Juno31/imu-daq/architecture.html

# IMU DAQ architecture

Firmware on the XIAO, a Python server on the PC, and a browser GUI. The board's frame timer is the master clock.

## XIAO ESP32S3 firmware/imu_daq/imu_daq.ino

BNO085 A4B0x4B

BNO085 A4A0x4A

→ I2C →

loop()reads IMUs, restarts silent ones

→

latest[]newest quaternions

esp_timerevery 10 ms (5 ms at 200 Hz)

→

onTick()snapshot latest[]

→

ring[512]frame queue

→

USB linesF (recording) / P (idle)

onTick()while recording

→

SYNC pin D1 high1 ms; 3 ms for frame 0

↓SYNC wireone pulse per frame (D1 → ai0)

↓USB serial (COM4)frames, @messages, ping/pong

## NI USB-6363

ai0 = SYNCedge timed to 1 sample

ai16 – ai23 = EMG01 – EMG08same sample clock (map below)

→ USB to the PC, read by daq.py

## PC: server.py conda env "daq"

daq.pyDAQ reader thread → daq_raw.f32, edge detection

device.pyserial reader thread → frames, @messages, pongs

clocksync.pyping/pong → board↔PC clock fit

syncmon.pylive pulse↔frame matching

session.pywrites the session folder

Appstate machine + HTTP server (port 8765)

↓HTTP + live stream (SSE)frames every 40 ms, status every 250 ms

## Browser GUI index.html + app.js + app.css

ButtonsStart / Stop / Marker / settings

IMU cards3D view, angles, plots

Sync monitorscope, match strip, clock plots

Log + sessionsevents, recent recordings

## DAQ channel map (Differential: AI n+ with AI n+8 −)

Signal | Muscle | Side | Channel | + pin | − pin
SYNC | XIAO D1 | — | ai0 | AI 0 | AI 8
EMG01 | Lumbar erector spinae | L | ai16 | AI 16 | AI 24
EMG02 | Lumbar erector spinae | R | ai17 | AI 17 | AI 25
EMG03 | Lumbar multifidus | L | ai18 | AI 18 | AI 26
EMG04 | Lumbar multifidus | R | ai19 | AI 19 | AI 27
EMG05 | External oblique | L | ai20 | AI 20 | AI 28
EMG06 | External oblique | R | ai21 | AI 21 | AI 29
EMG07 | Internal oblique | L | ai22 | AI 22 | AI 30
EMG08 | Internal oblique | R | ai23 | AI 23 | AI 31

GUI → Time sync → Extra channels: ai16,ai17,ai18,ai19,ai20,ai21,ai22,ai23. EMG system ground also to a DAQ AI GND pin. The range (±5 / ±10 V) applies to all channels.

## How the three clocks are linked

Link | How | Accuracy
Board → DAQ | SYNC pulse per frame, in hardware | ≈ 14 µs at 20 kHz
Board → PC | USB ping/pong, line fit | ≈ ±0.4 ms
DAQ → EMG / other inputs | same sample clock | exact

SID Lab spine study (frozen design): 7 BNO086 pods C7–S1 on two TCA9548A muxes and a Teensy 4.1 logger, 4 paraspinal EMG + 1 ECG on MyoWare 2, an NI USB-6003, two 10 m Cat6 tethers, and a laptop on battery. The Teensy frame timer is the master clock; its SYNC edge is recorded on AI4.

Solid blue: I2C (Qwiic) · grey: USB · dashed / thick red: SYNC + Cable B · orange: EMG / ECG analog + Cable A. Pods 1–4 (C7–T9) on Mux A ports 0–3 and pods 5–7 (T12–S1) on Mux B ports 0–2, confirmed by the lab.

## Tether pinout (RJ45 → spring terminal)

Cable | RJ45 pins | Signal | DAQ input
A | 1 / 2 | EMG1 L longissimus (signal / own GND) | AI0 / AI GND
A | 3 / 6 | EMG2 R longissimus | AI1 / AI GND
A | 4 / 5 | EMG3 L multifidus | AI2 / AI GND
A | 7 / 8 | EMG4 R multifidus | AI3 / AI GND
B | 1 | SYNC (Teensy pin 2) | AI4
B | 3 | ECG | AI5
B | 2 / 6 / 8 | GND (8 = bias) | AI GND
— (at the DAQ) | jumper | MARK: GUI pulses digital out P0.0 | AI6

Event marker: the GUI Mark key pulses USB-6003 digital output P0.0; a short jumper on the DAQ terminal block feeds it to AI6, so each marker is sampled on the same 2 kHz clock as EMG and SYNC (±0.5 ms). This replaces the hub Qwiic Button (frozen in the brief; confirm with the senior before removing its cutout in brace_v4.scad).

Safety: the laptop runs on battery while recording (no mains loop). Never plug a powered Link Shield lead into a Cable Shield jack; never switch MyoWare modes while powered.

## Parts status (purchase list)

Block | Part | Qty | Use | Status
IMU | SparkFun BNO086 Qwiic SEN-22857 | 8 | 7 pods + 1 spare | arrived
IMU | Qwiic Button BOB-15932 | 2 | spares (GUI marker on AI6 replaces the MARK button) | arrived
IMU | Qwiic Mux TCA9548A BOB-16784 | 2 | Mux A, Mux B | expected 26.11.16
IMU | Qwiic cables 50 cm / 20 cm, cable kit | 10 / 10 / 2 | pod chain, hub | cables 26.11.16, kit arrived
Logger | Teensy 4.1 DEV-16996 | 1 | logger, SYNC | expected 26.11.16
EMG | MyoWare 2 DEV-27924 + Cable Shield + Link Shield | 8 each | 4 EMG + 1 ECG + 3 spare | shields arrived, sensors 26.11.16
EMG | CAB-12970 electrode cable 61 cm | 8 | electrodes | arrived
EMG | 3.5 mm TRS cable 30–50 cm, TRRS breakout 5764 | 10 / 8 | Link Shield leads → terminals | cables 26.11.16, breakouts arrived
Hub | Wago 221-415 | 5 | 3V3 / GND buses | expected 26.11.16
Tether | Cat6 FTP 10 m + RJ45 spring adapters | 2 / 4 | Cable A, Cable B, both ends | arrived
Hub | microSD 32 GB, power bank (always-on), jumpers, resistors | — | logging, power, gain-check divider | arrived

Not in the list: the NI USB-6003 (assumed already in the lab). With 6 of 8 AI inputs used, 8 EMG channels would not fit on this DAQ.
