Juno31/imu-daq/assets/imu_daq.png

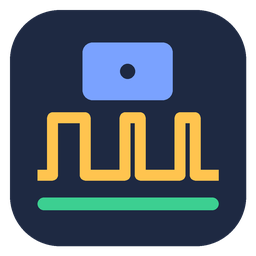
assets/imu_daq.png
