Juno31/imu-daq/hardware/dimension/myoware2/board_dimensions.png

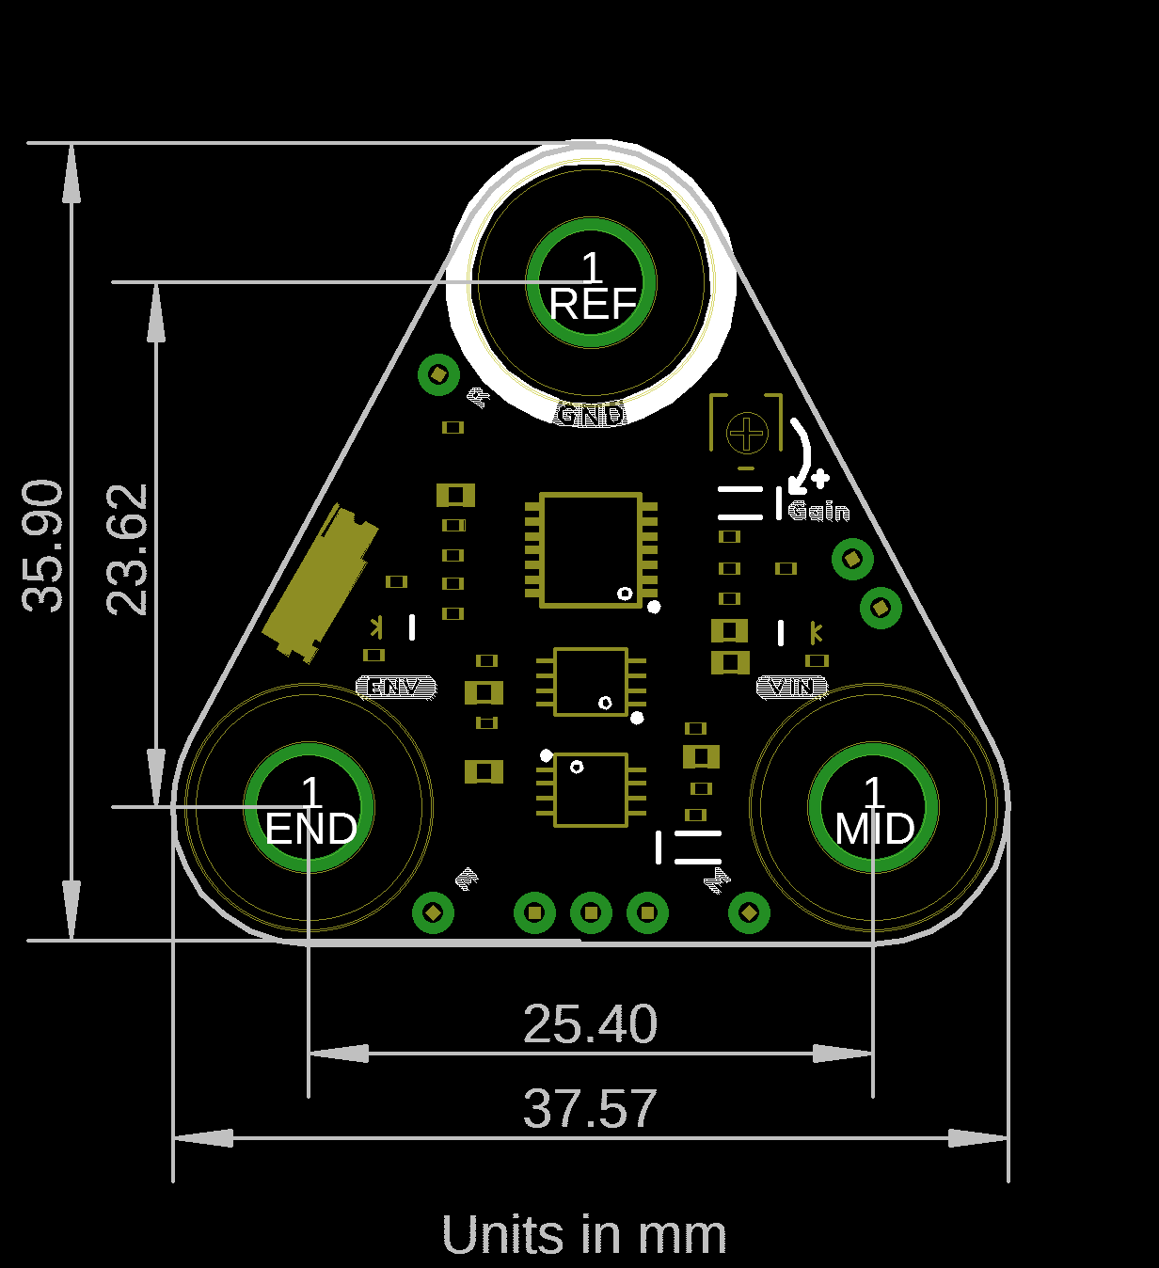
hardware/dimension/myoware2/board_dimensions.png
