Juno31/imu-daq/hardware/jig/preview_bottom.png

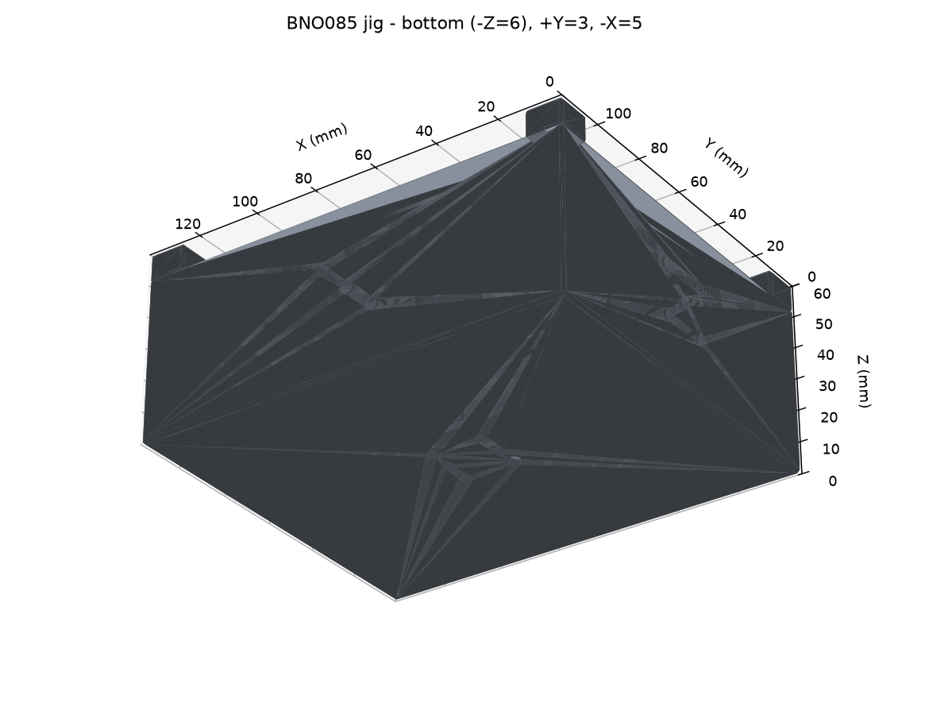
hardware/jig/preview_bottom.png
