Juno31/imu-daq/hardware/jig/preview_coupon.png

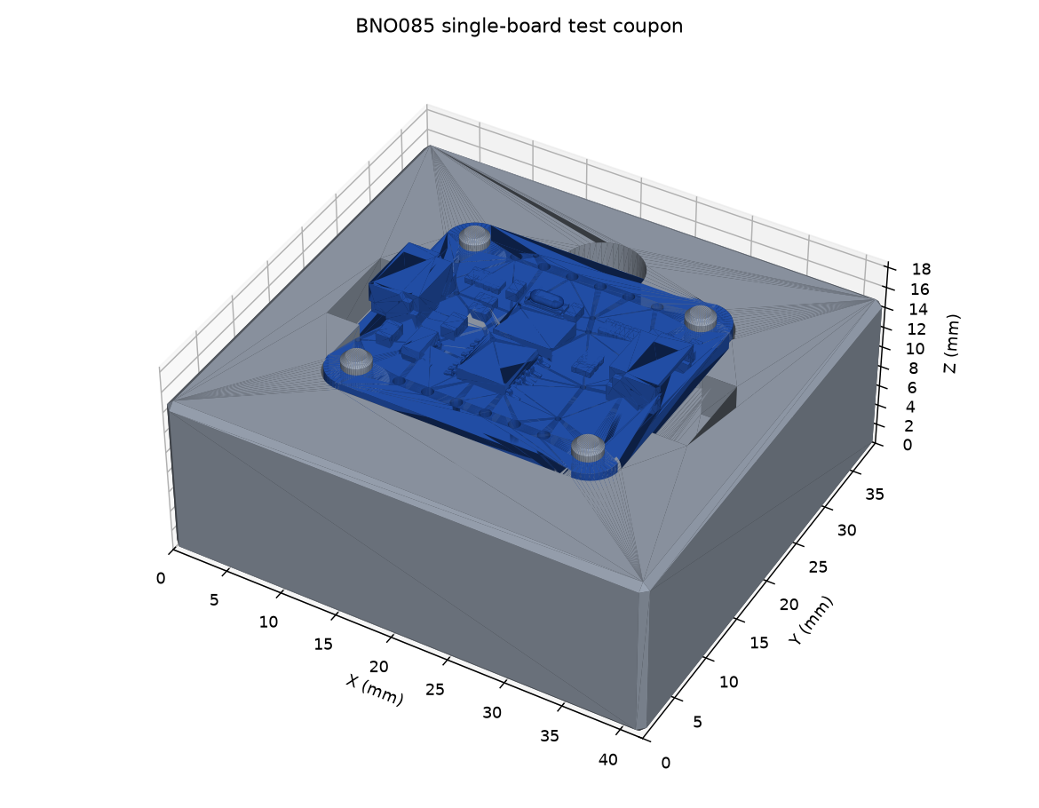
hardware/jig/preview_coupon.png
