Juno31/imu-daq/hardware/jig/preview_coupon_BNO086.png

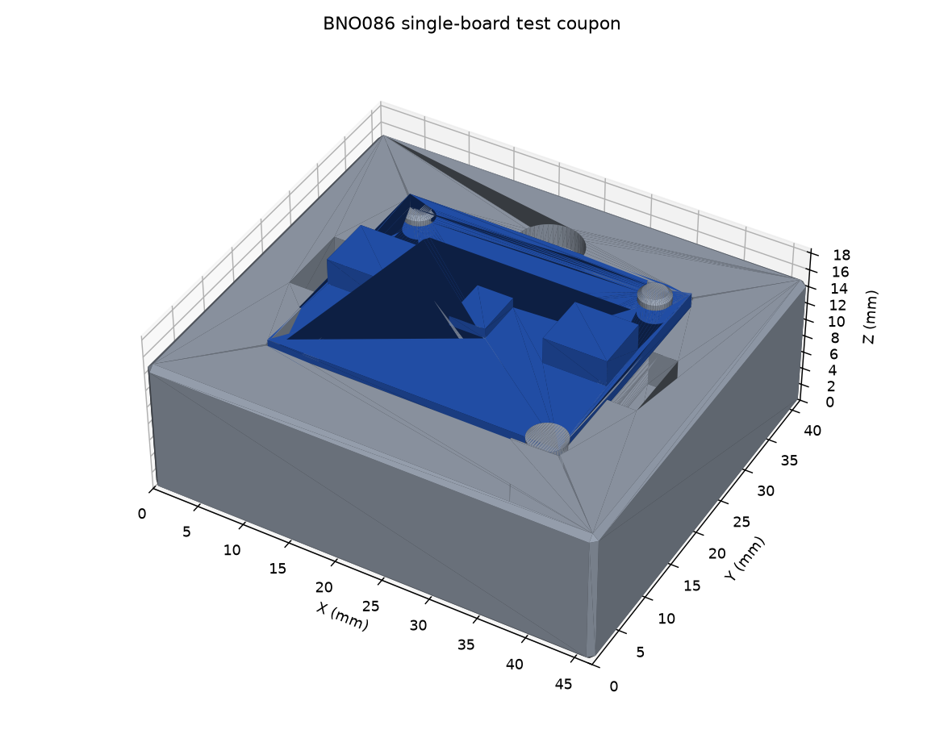
hardware/jig/preview_coupon_BNO086.png
