Juno31/imu-daq/hardware/jig/preview_coupon_empty.png

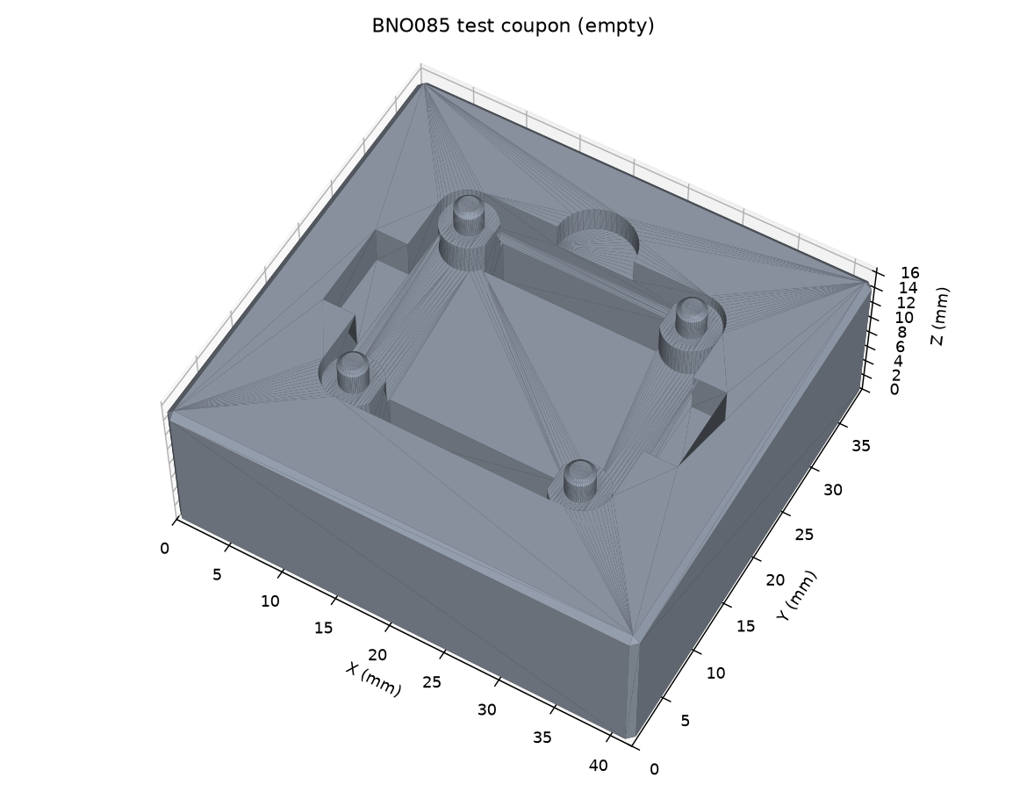
hardware/jig/preview_coupon_empty.png
