Juno31/imu-daq/hardware/jig/preview_coupon_snap.png

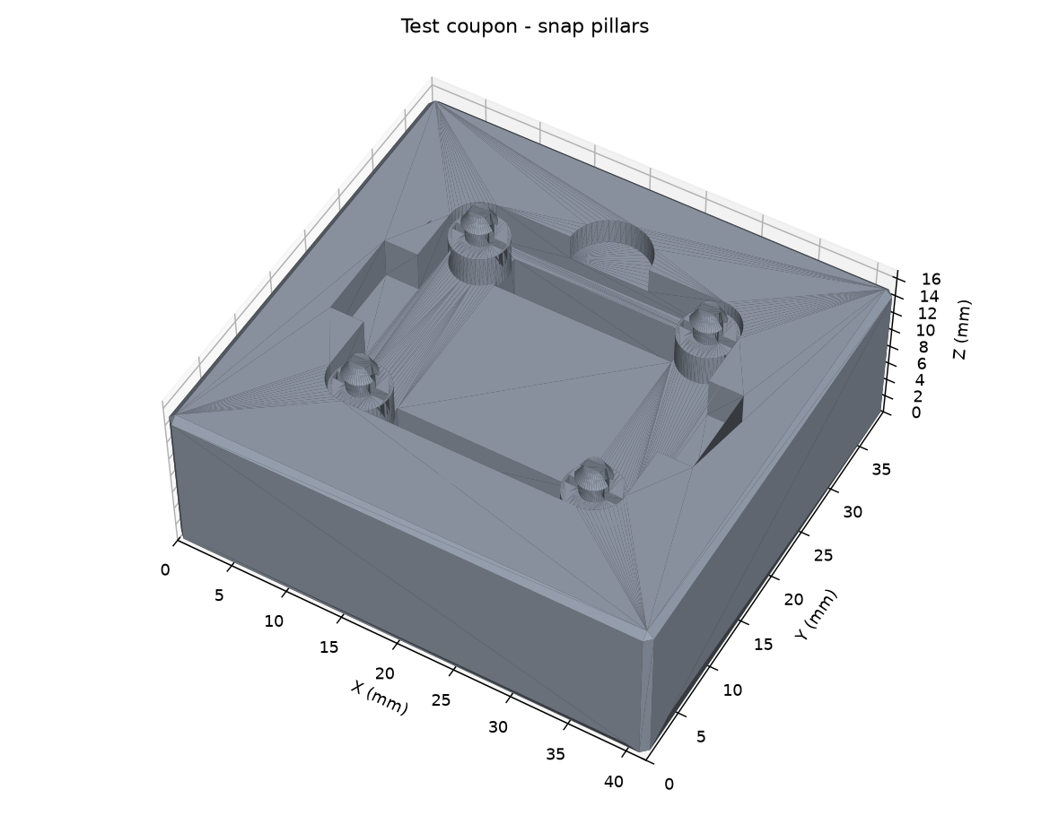
hardware/jig/preview_coupon_snap.png
