Juno31/imu-daq/hardware/jig/preview_iso.png

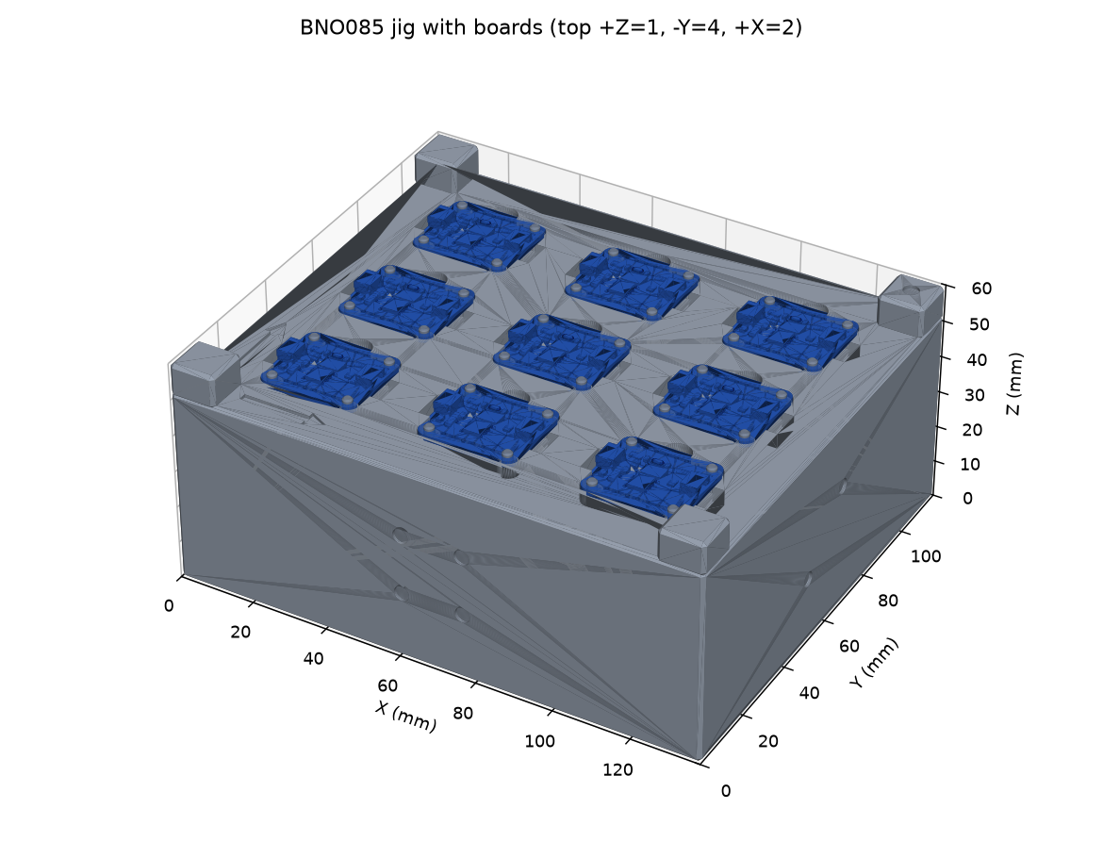
hardware/jig/preview_iso.png
