Juno31/imu-daq/hardware/jig/preview_pin_closeup.png

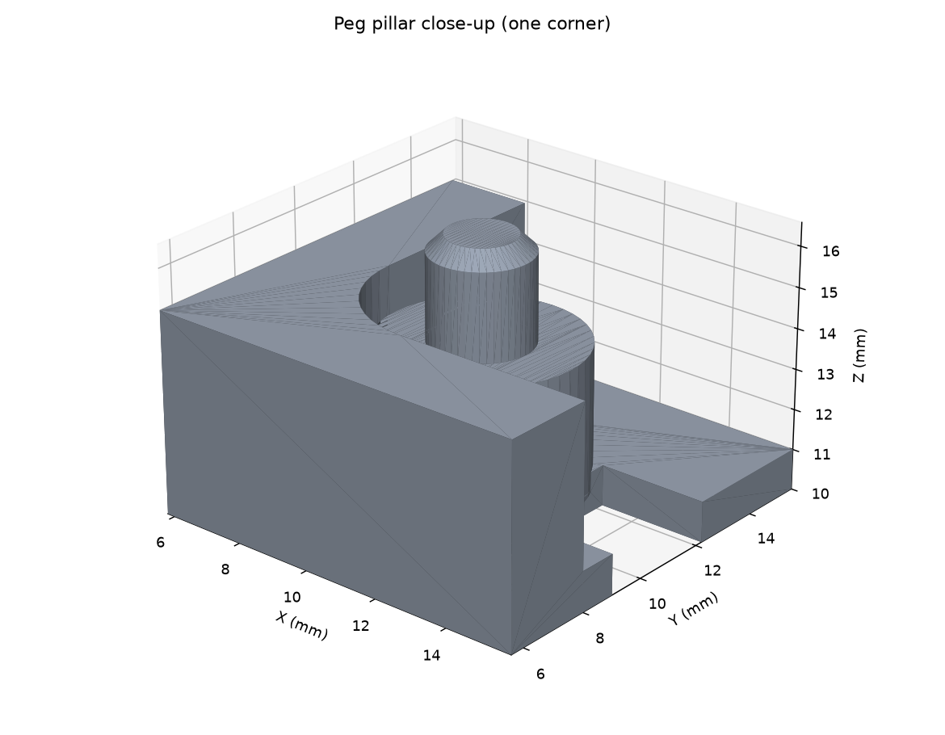
hardware/jig/preview_pin_closeup.png
