Juno31/imu-daq/hardware/dimension/dimensions.csv

board | feature | value_mm | basis | source
XIAO ESP32S3 | nominal_length | 21 | manufacturer specification | https://wiki.seeedstudio.com/xiao_esp32s3_getting_started/
XIAO ESP32S3 | nominal_width | 17.8 | manufacturer specification | https://wiki.seeedstudio.com/xiao_esp32s3_getting_started/
XIAO ESP32C3 | nominal_length | 21 | manufacturer specification | https://wiki.seeedstudio.com/XIAO_ESP32C3_Getting_Started/
XIAO ESP32C3 | nominal_width | 17.8 | manufacturer specification | https://wiki.seeedstudio.com/XIAO_ESP32C3_Getting_Started/
Adafruit BNO085 | CAD_outline_X | 25.4 | Eagle layer 20 | adafruit_bno085/Adafruit_BNO08x.brd
Adafruit BNO085 | CAD_outline_Y | 22.86 | Eagle layer 20 | adafruit_bno085/Adafruit_BNO08x.brd
Adafruit BNO085 | corner_radius | 2.54 | derived from Eagle arc endpoints and 90 degree sweep | adafruit_bno085/Adafruit_BNO08x.brd
Adafruit BNO085 | mount_hole_drill | 2.5 | CAD plated pad drill; not guaranteed finished diameter | adafruit_bno085/Adafruit_BNO08x.brd
Adafruit BNO085 | mount_spacing_X | 20.32 | CAD coordinate subtraction | adafruit_bno085/Adafruit_BNO08x.brd
Adafruit BNO085 | mount_spacing_Y | 17.78 | CAD coordinate subtraction | adafruit_bno085/Adafruit_BNO08x.brd
Adafruit BNO085 | product_length | 25.6 | product listing differs from CAD | https://www.adafruit.com/product/4754
Adafruit BNO085 | product_width | 22.7 | product listing differs from CAD | https://www.adafruit.com/product/4754
Adafruit BNO085 | product_height | 4.6 | product listing; not PCB thickness | https://www.adafruit.com/product/4754
SparkFun BNO086 | CAD_outline_X | 30.48 | Eagle layer 20 | https://docs.sparkfun.com/SparkFun_VR_IMU_Breakout_BNO086_QWIIC/single_page/
SparkFun BNO086 | CAD_outline_Y | 25.4 | Eagle layer 20 | https://docs.sparkfun.com/SparkFun_VR_IMU_Breakout_BNO086_QWIIC/single_page/
SparkFun BNO086 | mount_hole_diameter | 3.302 | Eagle STAND-OFF hole | https://docs.sparkfun.com/SparkFun_VR_IMU_Breakout_BNO086_QWIIC/single_page/
SparkFun BNO086 | mount_spacing | 25.4 | CAD coordinate subtraction | https://docs.sparkfun.com/SparkFun_VR_IMU_Breakout_BNO086_QWIIC/single_page/
SparkFun BNO086 | assembled_height |  | not verified | https://docs.sparkfun.com/SparkFun_VR_IMU_Breakout_BNO086_QWIIC/single_page/
MyoWare 2 DEV-27924 | outline_width | 37.57 | official dimension drawing | https://www.sparkfun.com/myoware-2-muscle-sensor.html
MyoWare 2 DEV-27924 | outline_height_in_plane | 35.9 | official dimension drawing | https://www.sparkfun.com/myoware-2-muscle-sensor.html
MyoWare 2 DEV-27924 | END_MID_center_spacing | 25.4 | official dimension drawing | https://www.sparkfun.com/myoware-2-muscle-sensor.html
MyoWare 2 DEV-27924 | REF_vertical_offset_from_END_MID | 23.62 | official dimension drawing | https://www.sparkfun.com/myoware-2-muscle-sensor.html
MyoWare 2 DEV-27924 | assembled_height |  | not verified | https://www.sparkfun.com/myoware-2-muscle-sensor.html
Teensy 4.1 DEV-16996 | PCB_length | 60.96 | PJRC drawing | https://www.pjrc.com/store/teensy41.html
Teensy 4.1 DEV-16996 | PCB_width | 17.78 | PJRC drawing | https://www.pjrc.com/store/teensy41.html
Teensy 4.1 DEV-16996 | PCB_width_tolerance_plus_minus | 0.6 | PJRC drawing | https://www.pjrc.com/store/teensy41.html
Teensy 4.1 DEV-16996 | PCB_thickness | 1.57 | PJRC drawing | https://www.pjrc.com/store/teensy41.html
Teensy 4.1 DEV-16996 | pin_pitch | 2.54 | PJRC drawing | https://www.pjrc.com/store/teensy41.html
Teensy 4.1 DEV-16996 | outer_pin_row_spacing | 15.24 | PJRC drawing | https://www.pjrc.com/store/teensy41.html
Teensy 4.1 DEV-16996 | USB_front_overhang | 0.7 | PJRC drawing | https://www.pjrc.com/store/teensy41.html
Teensy 4.1 DEV-16996 | USB_above_PCB | 2.5 | PJRC side drawing | https://www.pjrc.com/store/teensy41.html
Teensy 4.1 DEV-16996 | USB_below_PCB | 0.6 | PJRC side drawing | https://www.pjrc.com/store/teensy41.html
Teensy 4.1 DEV-16996 | finished_hole_59_locations | 0.965 | PJRC product text | https://www.pjrc.com/store/teensy41.html
Teensy 4.1 DEV-16996 | finished_hole_6_locations | 0.762 | PJRC product text | https://www.pjrc.com/store/teensy41.html
Teensy 4.1 DEV-16996 | assembled_height_with_headers |  | not verified; header dimensions unavailable | https://www.pjrc.com/store/teensy41.html
