Juno31/imu-daq/hardware/dimension/adafruit_bno085/4754_BNO085_STEMMA_QT.step

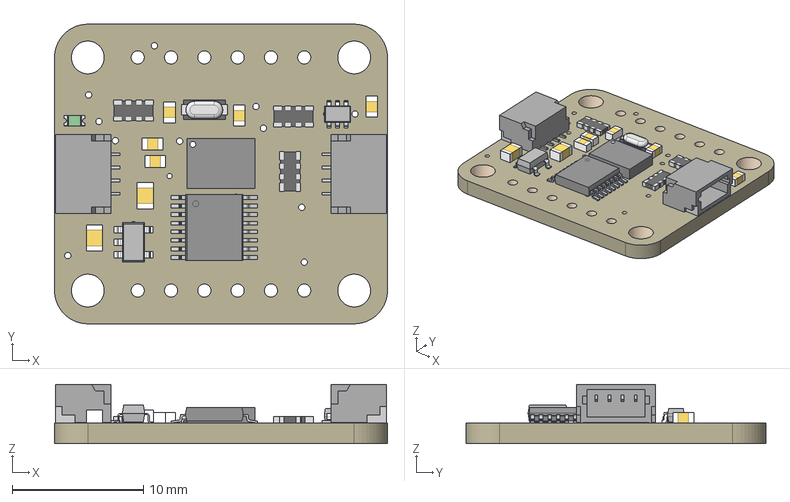
[picture p11: CAD file, 2026-11-13]
hardware/dimension/adafruit_bno085/4754_BNO085_STEMMA_QT.step
25.4 x 22.9 x 4.53 mm
Board
10uF x 2
AP2112K-3.3
22pF x 5
10K x 3
BSS138
STEMMA_I2C_QT x 2
GREEN
BNO080
74AHC4050
