Juno31/imu-daq/hardware/dimension/xiao_esp32c3/bottom_dimensions_v1.2_extracted/XIAO ESP32C3 v1.2 Dimensioning.dxf

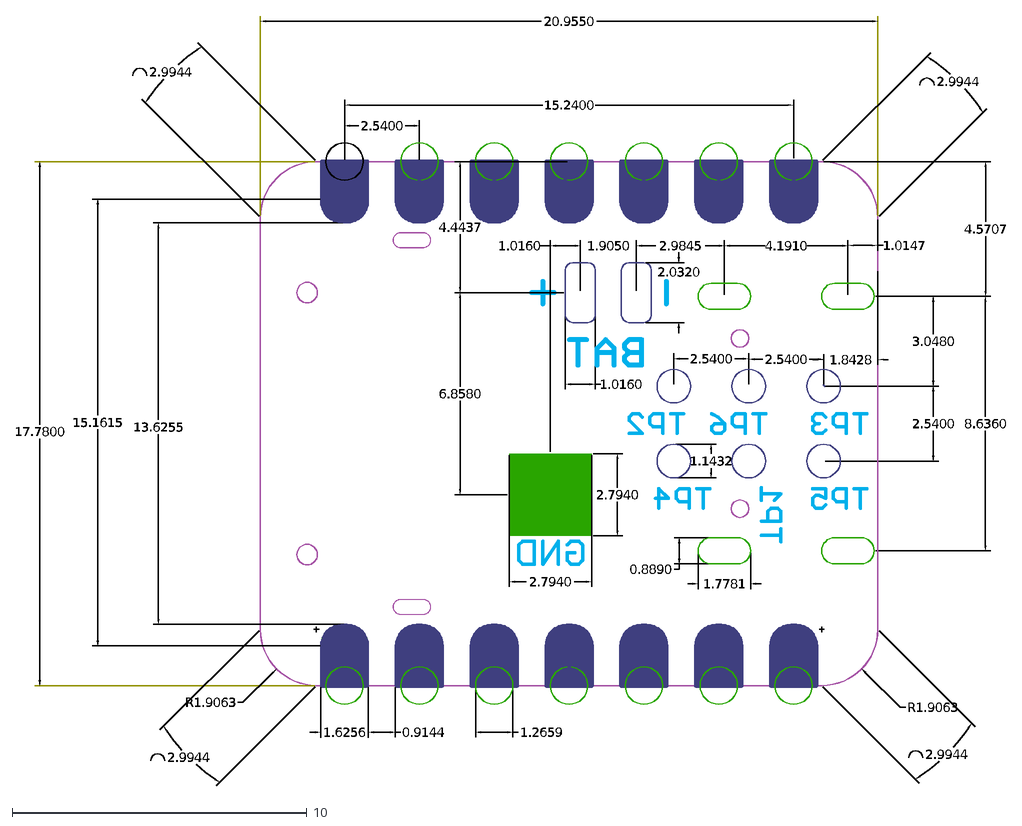
[picture p12: CAD file, 2026-11-13]
hardware/dimension/xiao_esp32c3/bottom_dimensions_v1.2_extracted/XIAO ESP32C3 v1.2 Dimensioning.dxf
1.0160
1.9050
1.7781
0.8890
8.6360
2.5400
4.1910
1.1432
20.9550
17.7800
15.2400
1.6256
R1.9063
2.9944
0.9144
13.6255
15.1615
1.2659
2.9845
1.0147
3.0480
1.8428
4.4437
2.0320
4.5707
2.7940
6.8580
