Juno31/imu-daq/hardware/dimension/xiao_esp32c3/dimensions_extracted/113991054/top.dxf

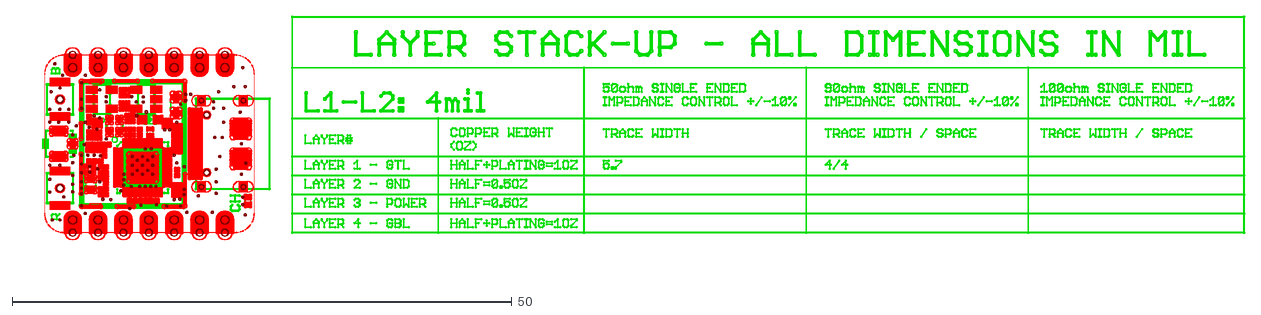
[picture p13: CAD file, 2026-11-13]
hardware/dimension/xiao_esp32c3/dimensions_extracted/113991054/top.dxf
122.9 x 25.9
