Juno31/imu-daq/hardware/dimension/xiao_esp32s3/dimensions_v1.1.dxf

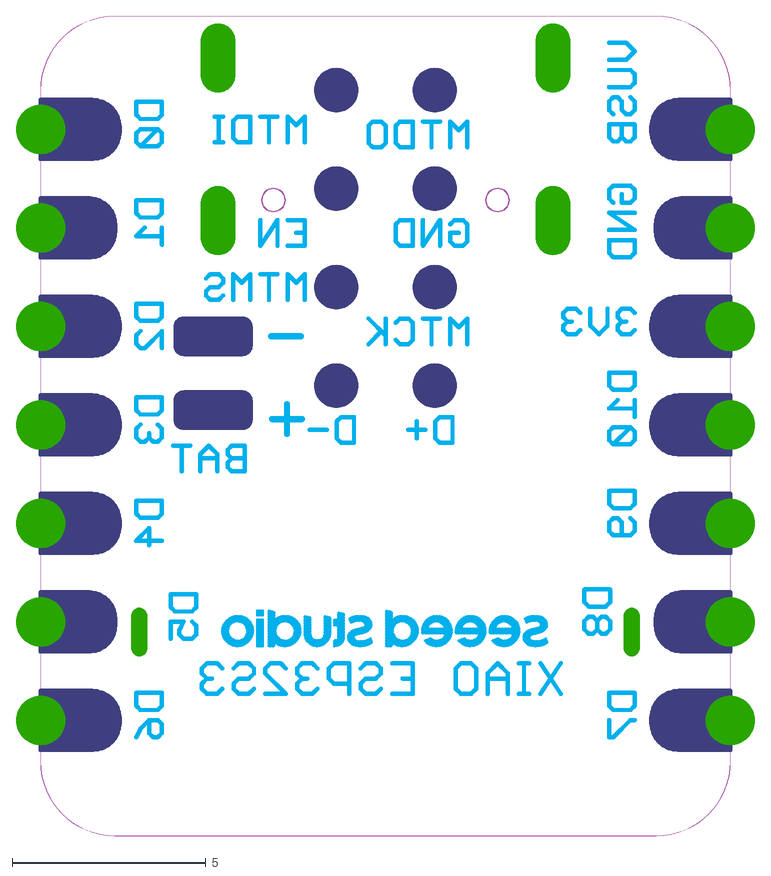
[picture p14: CAD file, 2026-11-13]
hardware/dimension/xiao_esp32s3/dimensions_v1.1.dxf
19.0 x 21.1
