Juno31/imu-daq/hardware/dimension/xiao_esp32c3/dimensions_extracted/113991054/bottom.dxf

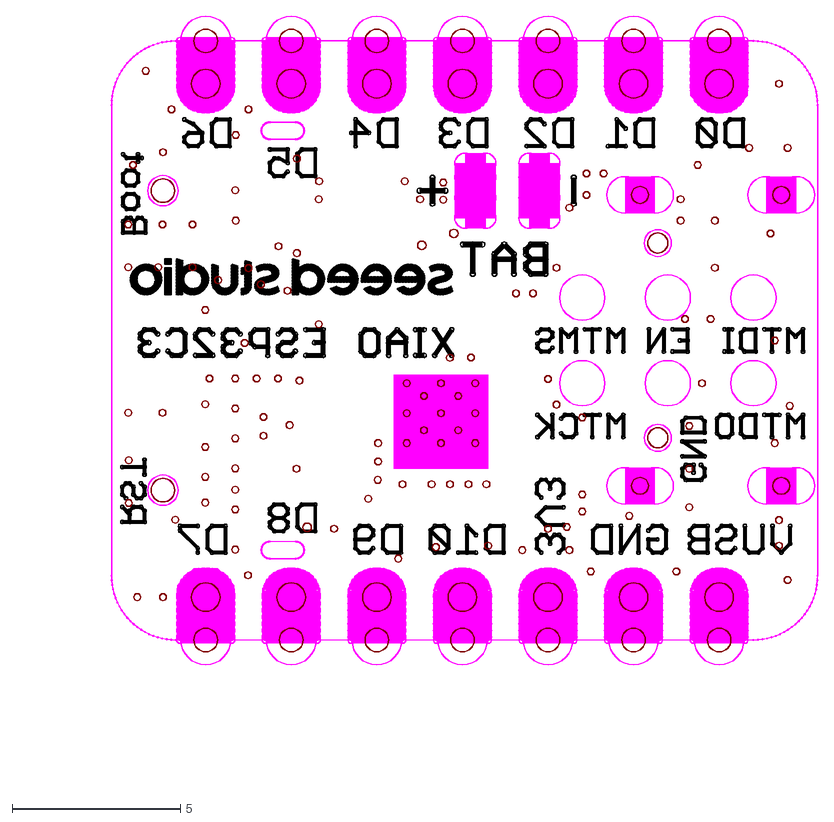
[picture p17: CAD file, 2026-11-13]
hardware/dimension/xiao_esp32c3/dimensions_extracted/113991054/bottom.dxf
23.8 x 22.7
