Juno31/imu-daq/hardware/jig/imu_jig_PLA-CF.stl

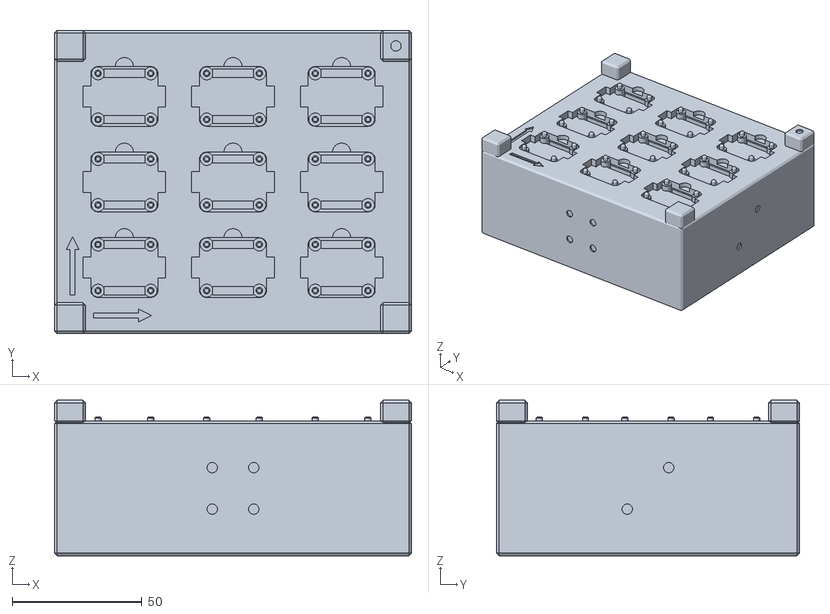
[picture p18: CAD file, 2026-11-13]
hardware/jig/imu_jig_PLA-CF.stl
137.7 x 117.0 x 60.0
