Juno31/imu-daq/hardware/jig/imu_jig_test_coupon_peg_BNO086_PLA-CF.stl

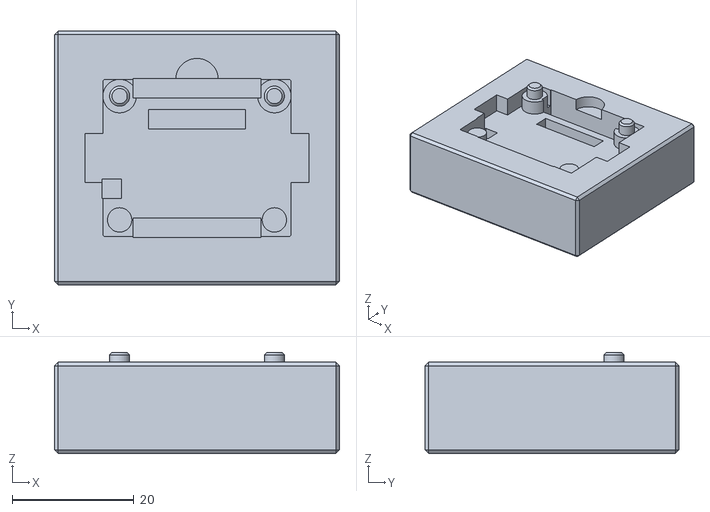
[picture p19: CAD file, 2026-11-13]
hardware/jig/imu_jig_test_coupon_peg_BNO086_PLA-CF.stl
46.8 x 41.7 x 16.6
