Juno31/imu-daq/hardware/jig/imu_jig_test_coupon_peg_PLA-CF.stl

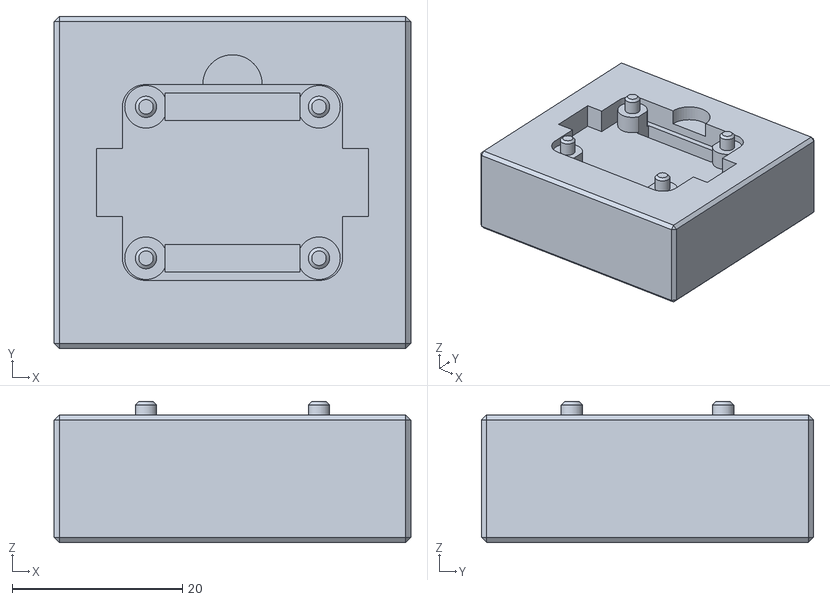
[picture p20: CAD file, 2026-11-13]
hardware/jig/imu_jig_test_coupon_peg_PLA-CF.stl
41.9 x 39.0 x 16.6
