Juno31/imu-daq/hardware/jig/imu_jig_BNO086_PLA-CF.stl

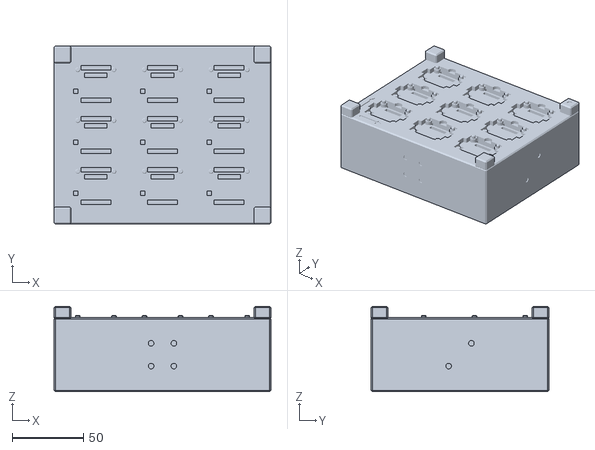
[picture p21: CAD file, 2026-11-13]
hardware/jig/imu_jig_BNO086_PLA-CF.stl
152.3 x 125.1 x 60.0
