Juno31/imu-daq/hardware/jig/imu_jig_test_coupon_screw.stl

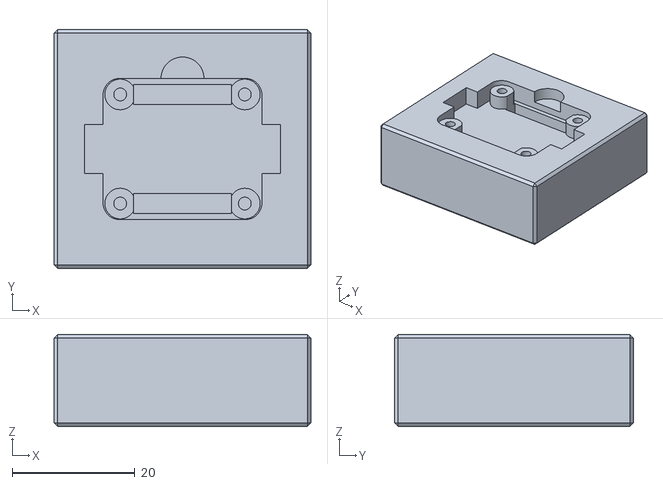
[picture p22: CAD file, 2026-11-13]
hardware/jig/imu_jig_test_coupon_screw.stl
41.9 x 39.0 x 15.0
