Juno31/imu-daq/(list of files, cad)

Other CAD files:
hardware/dimension/adafruit_bno085/4754_BNO085_STEMMA_QT.f3d
hardware/dimension/adafruit_bno085/4754_BNO085_STEMMA_QT.stl
