Juno31/imu-daq/hardware/dimension/adafruit_bno085/manufacturer_README.md

## Adafruit BNO085  9-DOF Orientation IMU Fusion Breakout PCB

<a href="http://www.adafruit.com/products/4754"><br/>
Click here to purchase one from the Adafruit shop</a>

PCB files for the Adafruit BNO085  9-DOF Orientation IMU Fusion Breakout. 

Format is EagleCAD schematic and board layout
* https://www.adafruit.com/product/4754

### Description

### License

Adafruit invests time and resources providing this open source design, please support Adafruit and open-source hardware by purchasing products from [Adafruit](https://www.adafruit.com)!

Designed by Limor Fried/Ladyada for Adafruit Industries.

Creative Commons Attribution/Share-Alike, all text above must be included in any redistribution. 
See license.txt for additional details.
