Juno31/imu-daq/hardware/jig/validation/fit_detail.png

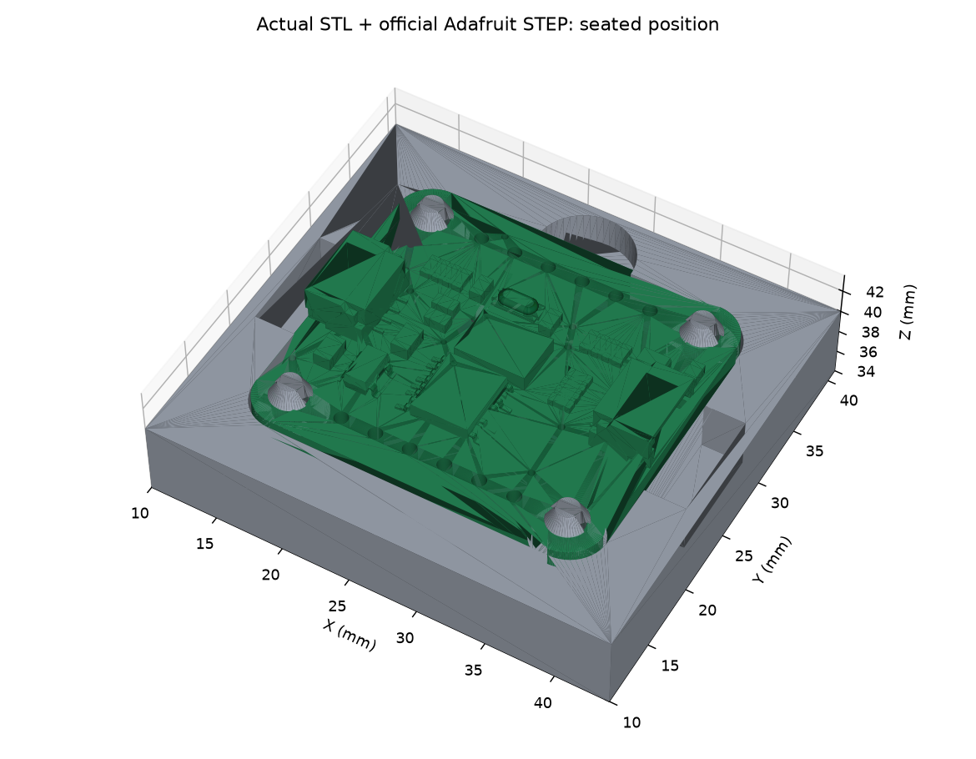
hardware/jig/validation/fit_detail.png
