Juno31/imu-daq/hardware/jig/validation/pin_section.png

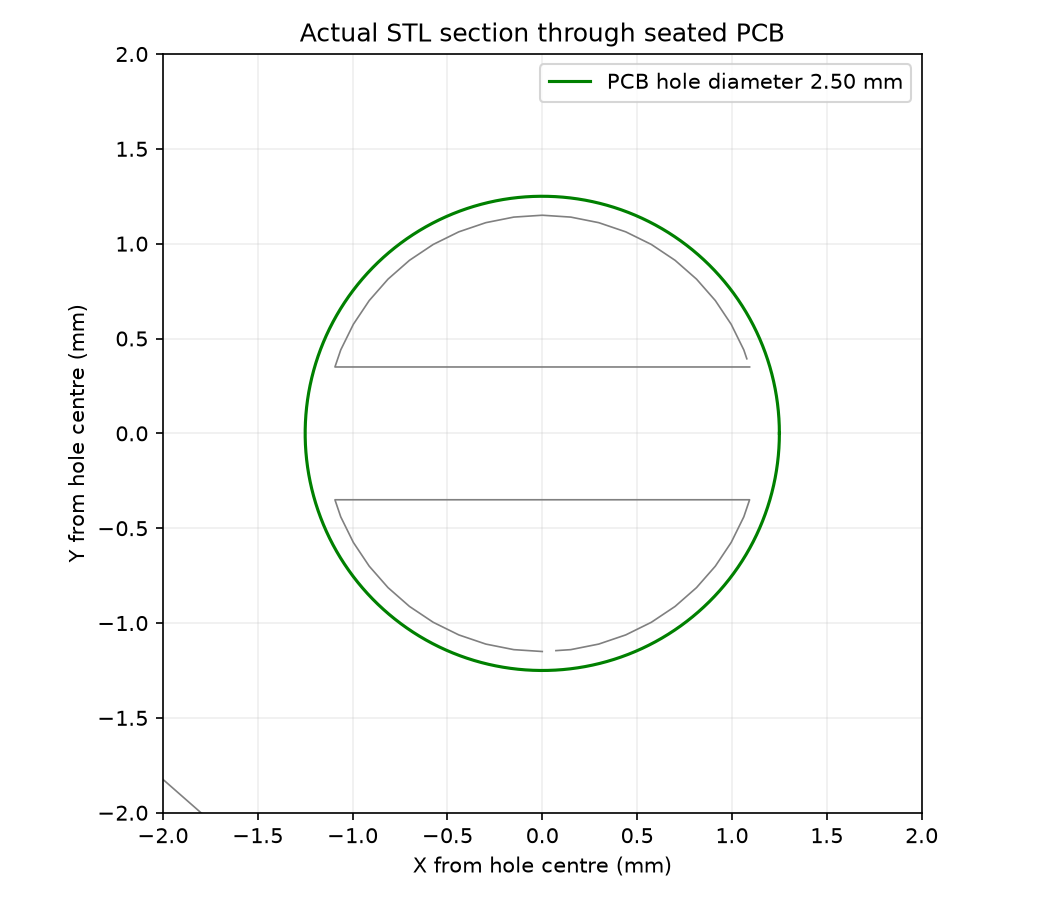
hardware/jig/validation/pin_section.png
