Juno31/imu-daq/(list of files, drawings)

Other design files:
hardware/dimension/adafruit_bno085/pcb_geometry.json
hardware/dimension/sparkfun_bno086/pcb_geometry.json
