Juno31/imu-daq/hardware/dimension/xiao_esp32s3/reference_mismatch/KiCad_extracted/202003753_XIAO ESP32S3 Sense_v1.5_SCH&PCB_260226/XIAO ESP32S3_V1.5.kicad_pcb

## KiCad design hardware/dimension/xiao_esp32s3/reference_mismatch/KiCad_extracted/202003753_XIAO ESP32S3 Sense_v1.5_SCH&PCB_260226/XIAO ESP32S3_V1.5.kicad_pcb (2026-11-13)

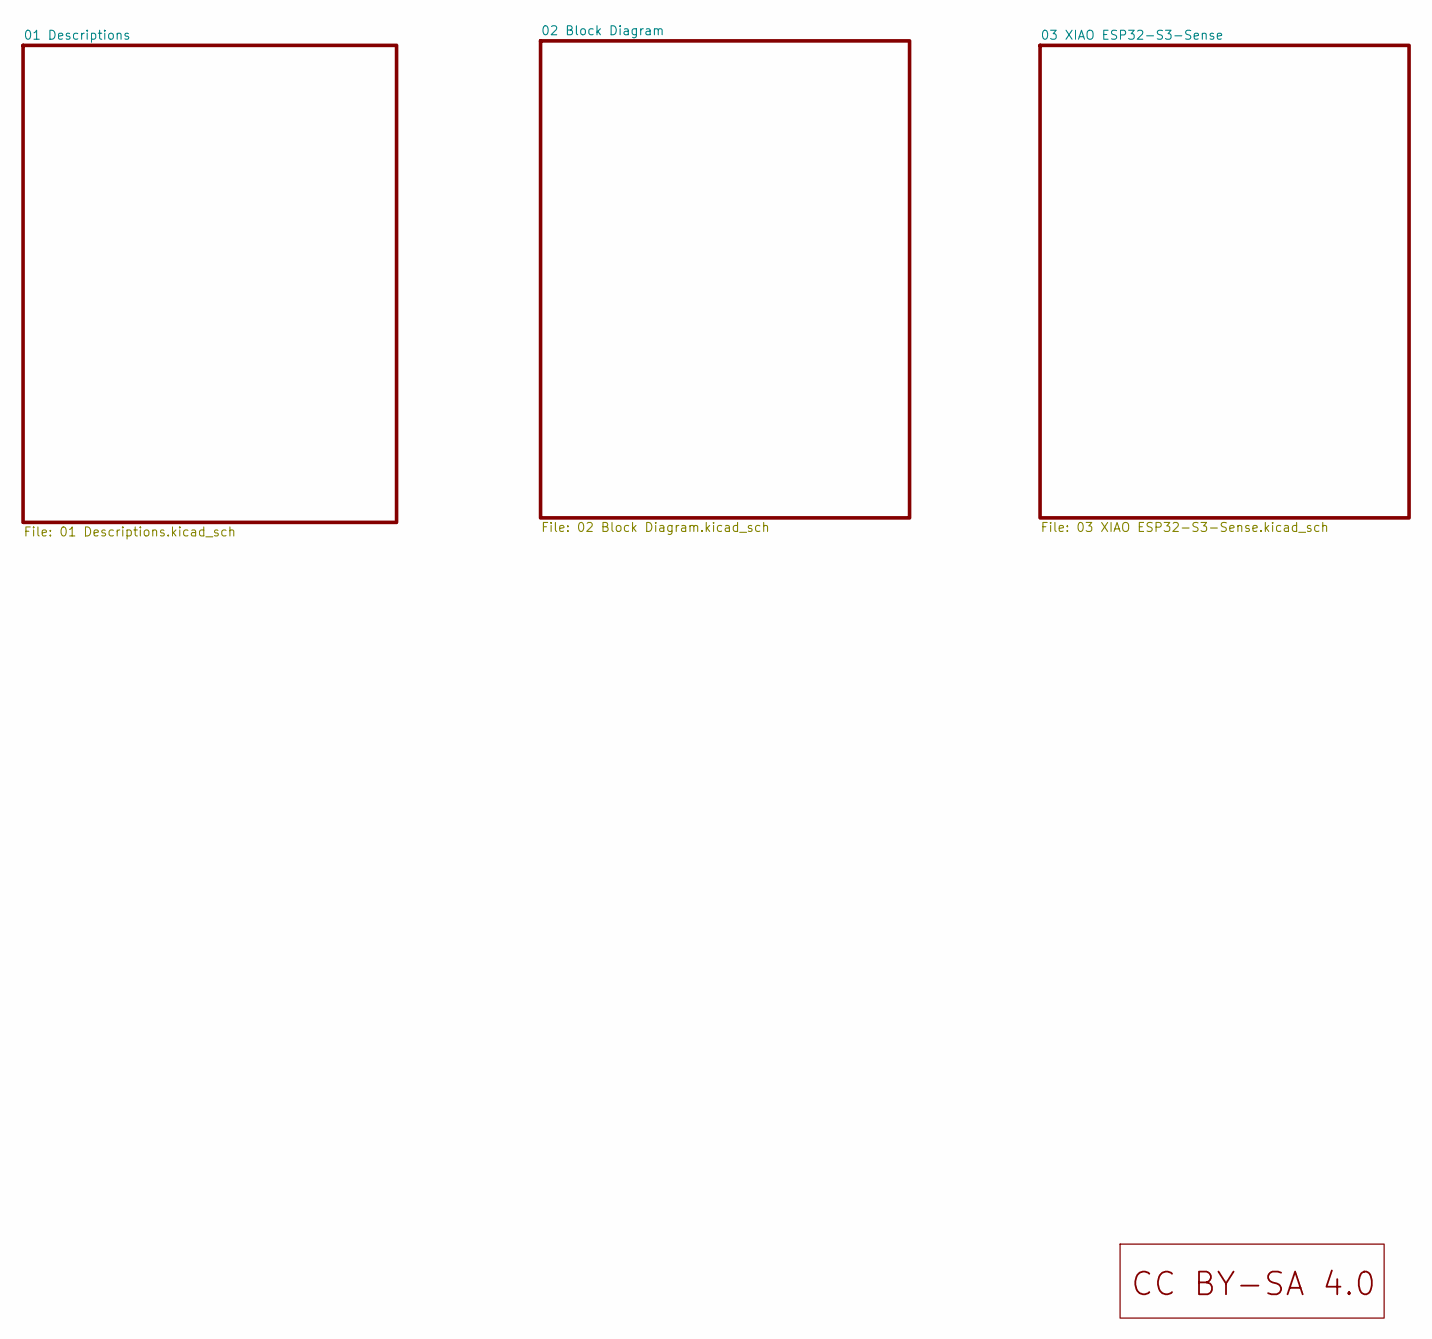
[picture p25: schematic XIAO ESP32S3_V1.5.kicad_sch, XIAO ESP32-S3-Sense]

Parts:
U6: LOGO_CC_BY-SA_4.0

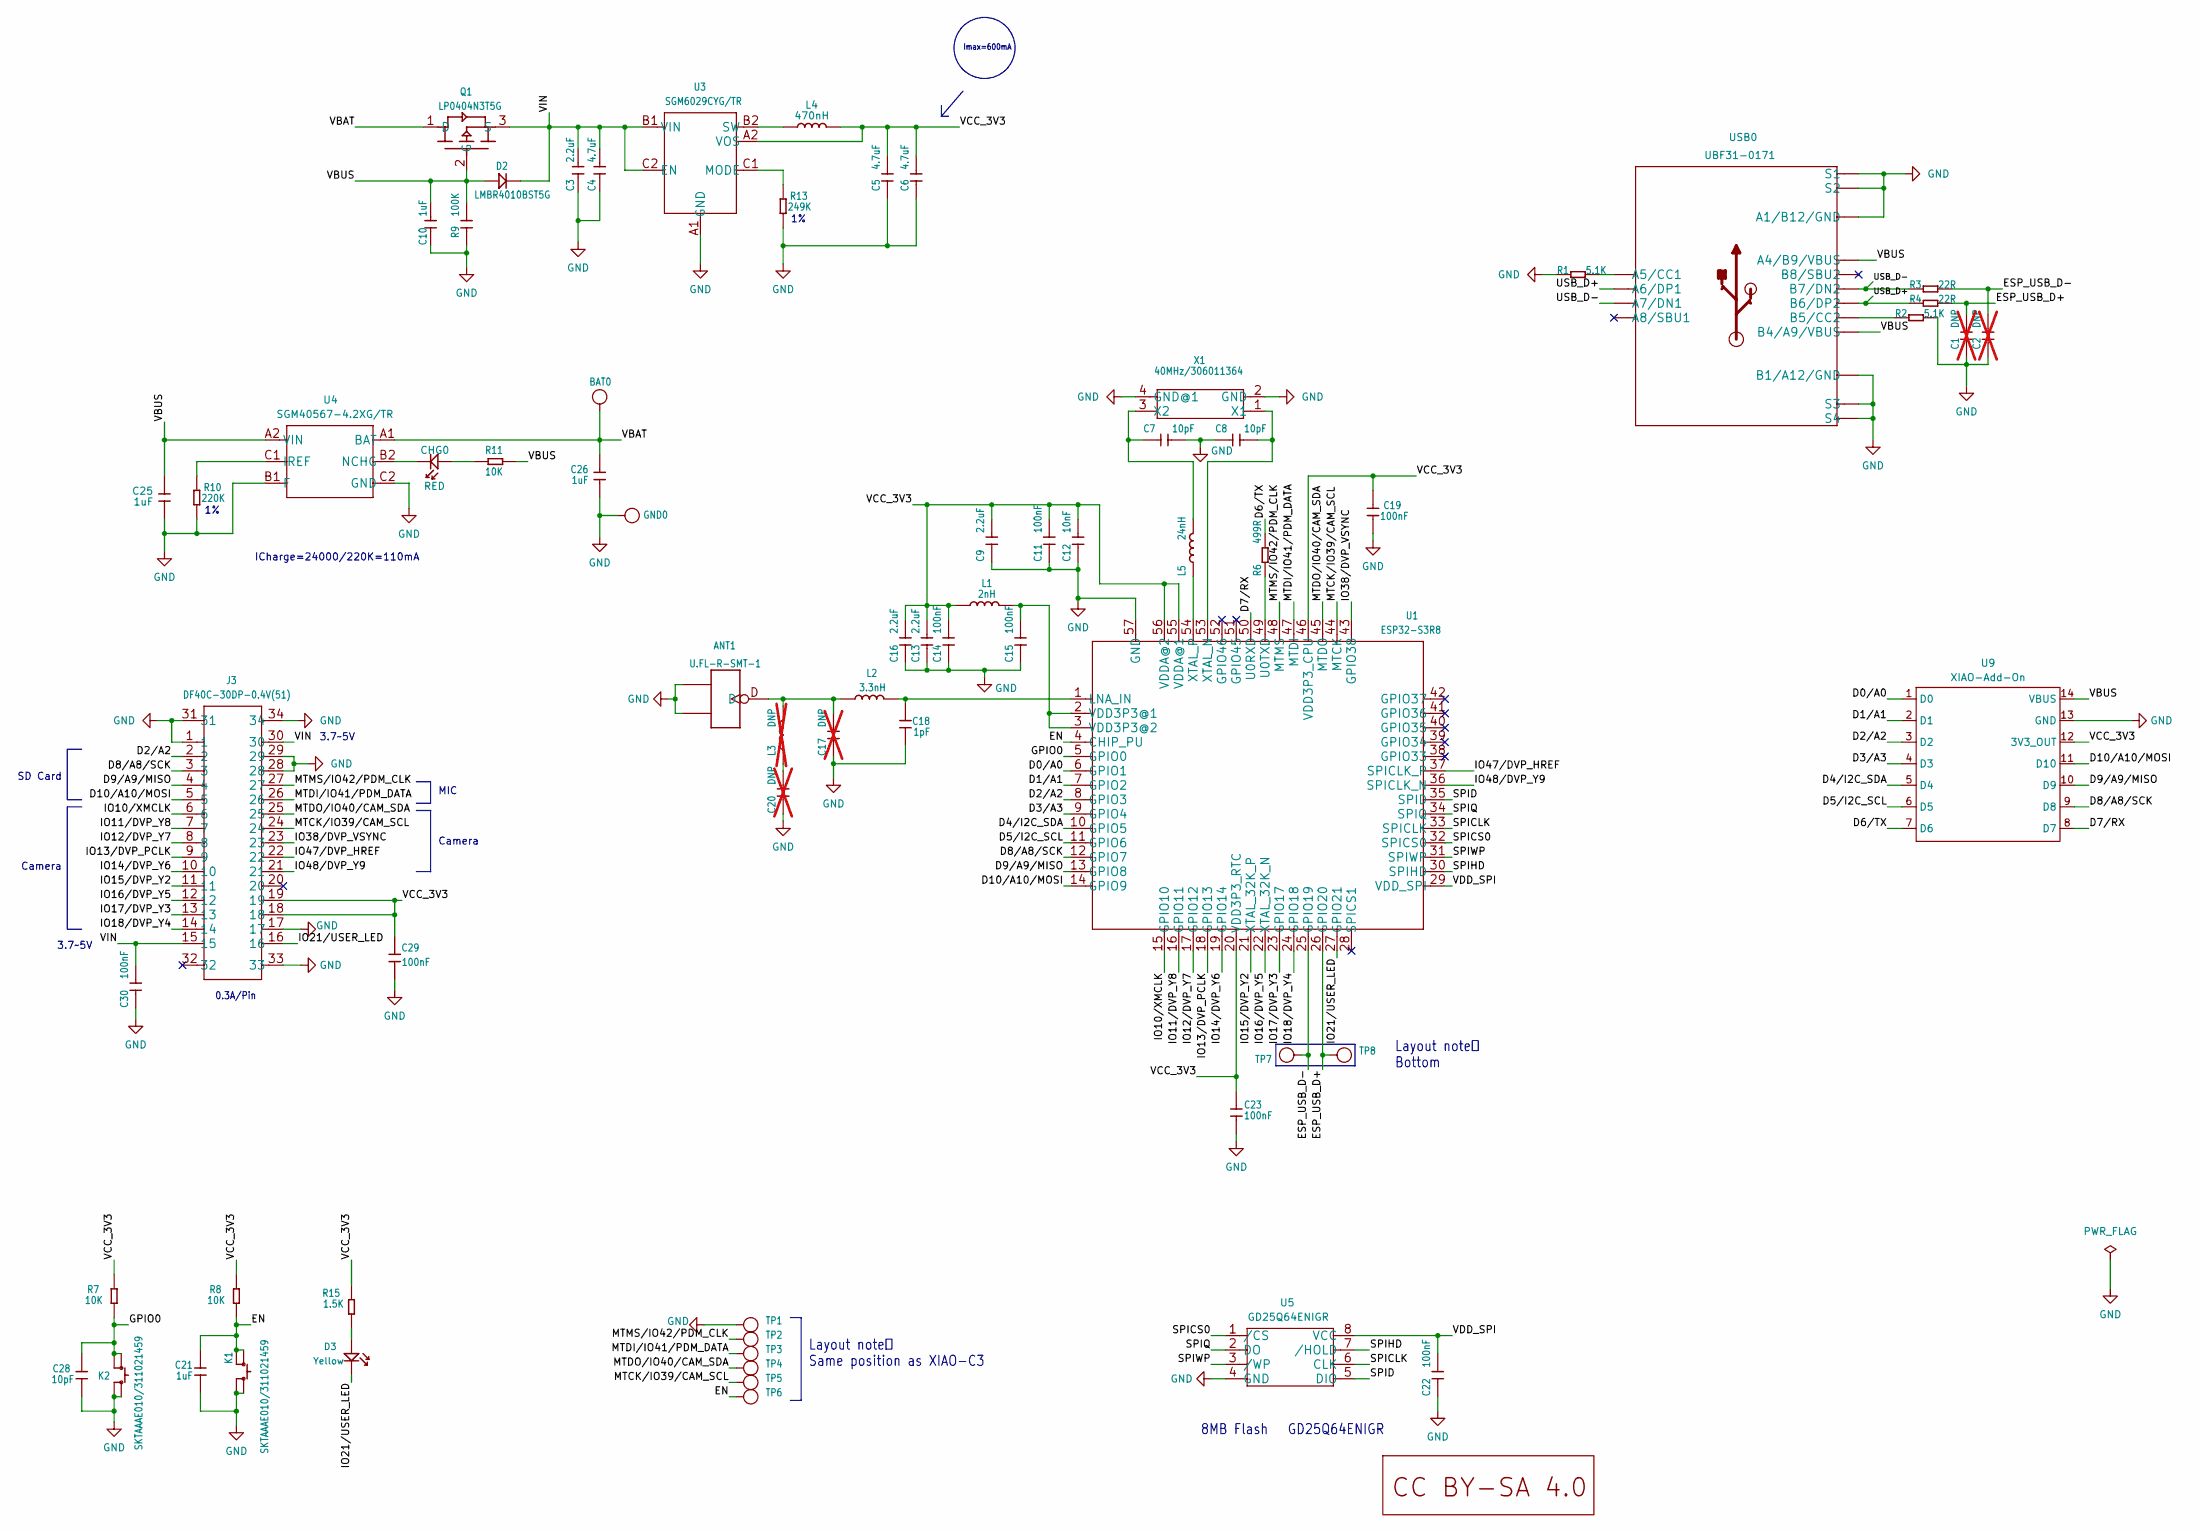
[picture p26: schematic 03 XIAO ESP32-S3-Sense.kicad_sch, XIAO ESP32-S3-Sense]

Parts:
ANT1: U.FL-R-SMT-1; U-FL3P-SMD-2.6X2.6X1.0MM
BAT0: VBAT; TP-80X40MIL
C1, C2, C17, C20: DNP; C0201; not fitted
C3, C9, C13, C16: 2.2uF; C0201
C4, C5, C6: 4.7uF; C0201
C7, C8, C28: 10pF; C0201
C10, C21, C25, C26: 1uF; C0201
C11, C14, C15, C19, C22, C23, C29, C30: 100nF; C0201
C12: 10nF; C0201
C18: 1pF; C0201
CHG0: RED; LED-0402
D2: LMBR4010BST5G; DFN1006-2L
D3: Yellow; LED-0402
GND0: GND; TP-80X40MIL
J3: DF40C-30DP-0.4V(51); BTB30-0.4-7.52X2.97X1.14
K1, K2: SKTAAAE010/311021459; SW4-SMD-2.8-2.6X1.6X0.53MM
L1: 2nH; L0201
L2: 3.3nH; L0201
L3: DNP; L0201; not fitted
L4: 470nH; L0603
L5: 24nH; L0201
Q1: LP0404N3T5G; PMOS_1.0_0.6_0.35MM
R1, R2: 5.1K; R0201
R3, R4: 22R; R0201
R6: 499R; R0201
R7, R8, R11: 10K; R0201
R9: 100K; C0201
R10: 220K; R0201
R13: 249K; R0201
R15: 1.5K; R0201
TP1, TP2, TP3, TP4, TP5, TP6, TP7, TP8: TEST-POINT'4545'; TP-D45MIL
U1: ESP32-S3R8; QFN56G-0.4-7X7MM
U3: SGM6029CYG/TR; BGA6-0.35-0.745X10.95X0.4MM
U4: SGM40567-4.2XG/TR; WLCSP-0.4-0.92X1.16X0.4MM
U5: GD25Q64ENIGR; USON8-0.8-4X3MM
U8: LOGO_CC_BY-SA_4.0
U9: XIAO-Add-On; XIAO-14P-Add-On
USB0: UBF31-0171; USB2.0-TYPE-C
X1: 40MHz/306011364; X4-SMD-1.6X1.2X0.35MM

Connections:
/03 XIAO ESP32-S3-Sense/D0/A0: U1.6 (GPIO1), U9.1 (D0)
/03 XIAO ESP32-S3-Sense/D1/A1: U1.7 (GPIO2), U9.2 (D1)
/03 XIAO ESP32-S3-Sense/D2/A2: J3.2, U1.8 (GPIO3), U9.3 (D2)
/03 XIAO ESP32-S3-Sense/D3/A3: U1.9 (GPIO4), U9.4 (D3)
/03 XIAO ESP32-S3-Sense/D4/I2C_SDA: U1.10 (GPIO5), U9.5 (D4)
/03 XIAO ESP32-S3-Sense/D5/I2C_SCL: U1.11 (GPIO6), U9.6 (D5)
/03 XIAO ESP32-S3-Sense/D6/TX: R6.2, U9.7 (D6)
/03 XIAO ESP32-S3-Sense/D7/RX: U1.50 (U0RXD), U9.8 (D7)
/03 XIAO ESP32-S3-Sense/D8/A8/SCK: J3.3, U1.12 (GPIO7), U9.9 (D8)
/03 XIAO ESP32-S3-Sense/D9/A9/MISO: J3.4, U1.13 (GPIO8), U9.10 (D9)
/03 XIAO ESP32-S3-Sense/D10/A10/MOSI: J3.5, U1.14 (GPIO9), U9.11 (D10)
/03 XIAO ESP32-S3-Sense/EN: C21.2, K1.1 (A0), K1.3 (A1), R8.1, TP6.T, U1.4 (CHIP_PU)
/03 XIAO ESP32-S3-Sense/ESP_USB_D+: C1.2, R4.2, TP8.T, U1.26 (GPIO20)
/03 XIAO ESP32-S3-Sense/ESP_USB_D-: C2.2, R3.2, TP7.T, U1.25 (GPIO19)
/03 XIAO ESP32-S3-Sense/GPIO0: C28.2, K2.1 (A0), K2.3 (A1), R7.1, U1.5 (GPIO0)
/03 XIAO ESP32-S3-Sense/IO10/XMCLK: J3.6, U1.15 (GPIO10)
/03 XIAO ESP32-S3-Sense/IO11/DVP_Y8: J3.7, U1.16 (GPIO11)
/03 XIAO ESP32-S3-Sense/IO12/DVP_Y7: J3.8, U1.17 (GPIO12)
/03 XIAO ESP32-S3-Sense/IO13/DVP_PCLK: J3.9, U1.18 (GPIO13)
/03 XIAO ESP32-S3-Sense/IO14/DVP_Y6: J3.10, U1.19 (GPIO14)
/03 XIAO ESP32-S3-Sense/IO15/DVP_Y2: J3.11, U1.21 (XTAL_32K_P)
/03 XIAO ESP32-S3-Sense/IO16/DVP_Y5: J3.12, U1.22 (XTAL_32K_N)
/03 XIAO ESP32-S3-Sense/IO17/DVP_Y3: J3.13, U1.23 (GPIO17)
/03 XIAO ESP32-S3-Sense/IO18/DVP_Y4: J3.14, U1.24 (GPIO18)
/03 XIAO ESP32-S3-Sense/IO21/USER_LED: D3.-, J3.16, U1.27 (GPIO21)
/03 XIAO ESP32-S3-Sense/IO38/DVP_VSYNC: J3.23, U1.43 (GPIO38)
/03 XIAO ESP32-S3-Sense/IO47/DVP_HREF: J3.22, U1.37 (SPICLK_P)
/03 XIAO ESP32-S3-Sense/IO48/DVP_Y9: J3.21, U1.36 (SPICLK_N)
/03 XIAO ESP32-S3-Sense/MTCK/IO39/CAM_SCL: J3.24, TP5.T, U1.44 (MTCK)
/03 XIAO ESP32-S3-Sense/MTDI/IO41/PDM_DATA: J3.26, TP3.T, U1.47 (MTDI)
/03 XIAO ESP32-S3-Sense/MTDO/IO40/CAM_SDA: J3.25, TP4.T, U1.45 (MTDO)
/03 XIAO ESP32-S3-Sense/MTMS/IO42/PDM_CLK: J3.27, TP2.T, U1.48 (MTMS)
/03 XIAO ESP32-S3-Sense/SPICLK: U1.33 (SPICLK), U5.6 (CLK)
/03 XIAO ESP32-S3-Sense/SPICS0: U1.32 (SPICS0), U5.1 (/CS)
/03 XIAO ESP32-S3-Sense/SPID: U1.35 (SPID), U5.5 (DIO)
/03 XIAO ESP32-S3-Sense/SPIHD: U1.30 (SPIHD), U5.7 (/HOLD)
/03 XIAO ESP32-S3-Sense/SPIQ: U1.34 (SPIQ), U5.2 (DO)
/03 XIAO ESP32-S3-Sense/SPIWP: U1.31 (SPIWP), U5.3 (/WP)
/03 XIAO ESP32-S3-Sense/USB_D+: R4.1, USB0.A6 (A6/DP1), USB0.B6 (B6/DP2)
/03 XIAO ESP32-S3-Sense/USB_D-: R3.1, USB0.A7 (A7/DN1), USB0.B7 (B7/DN2)
/03 XIAO ESP32-S3-Sense/VBAT: BAT0.1 (T), C26.1, Q1.1 (D), U4.A1 (BAT)
/03 XIAO ESP32-S3-Sense/VBUS: C10.1, C25.1, D2.+, Q1.2 (G), R9.2, R11.1, U4.A2 (VIN), U9.14 (VBUS), USB0.A4_B9 (A4/B9/VBUS), USB0.B4_A9 (B4/A9/VBUS)
/03 XIAO ESP32-S3-Sense/VCC_3V3: C5.2, C6.2, C9.2, C11.2, C12.2, C13.2, C14.2, C16.2, C19.2, C23.1, C29.2, J3.18, J3.19, L1.1, L4.2, R7.2, R8.2, R15.2, U1.20 (VDD3P3_RTC), U1.46 (VDD3P3_CPU), U1.55 (VDDA@1), U1.56 (VDDA@2), U3.A2 (VOS), U9.12 (3V3_OUT)
/03 XIAO ESP32-S3-Sense/VDD_SPI: C22.2, U1.29 (VDD_SPI), U5.8 (VCC)
/03 XIAO ESP32-S3-Sense/VIN: C3.1, C4.1, C30.2, D2.-, J3.15, J3.30, Q1.3 (S), U3.B1 (VIN), U3.C2 (EN)
GND: ANT1.GND1, ANT1.GND2, C1.1, C2.1, C3.2, C4.2, C5.1, C6.1, C7.2, C8.1, C9.1, C10.2, C11.1, C12.1, C13.1, C14.1, C15.1, C16.1, C17.1, C18.1, C19.1, C20.1, C21.1, C22.1, C23.2, C25.2, C26.2, C28.1, C29.1, C30.1, GND0.1 (T), J3.1, J3.17, J3.28, J3.29, J3.31, J3.33, J3.34, K1.2 (B0), K1.4 (B1), K2.2 (B0), K2.4 (B1), R1.1, R2.2, R9.1, R10.1, R13.1, TP1.T, U1.57 (GND), U3.A1 (GND), U4.B1 (F), U4.C2 (GND), U5.4 (GND), U9.13 (GND), USB0.A1_B12 (A1/B12/GND), USB0.B1_A12 (B1/A12/GND), USB0.S1, USB0.S2, USB0.S3, USB0.S4, USB0.S5 (S1), USB0.S6 (S2), X1.2 (GND), X1.4 (GND@1)
unnamed: ANT1.D, C17.2, L2.1, L3.2
unnamed: C20.2, L3.1
unnamed: CHG0.+, R11.2
unnamed: D3.+, R15.1
unnamed: C18.2, L2.2, U1.1 (LNA_IN)
unnamed: R6.1, U1.49 (U0TXD)
unnamed: C15.2, L1.2, U1.2 (VDD3P3@1), U1.3 (VDD3P3@2)
unnamed: C8.2, U1.53 (XTAL_N), X1.1 (X1)
unnamed: L5.1, U1.54 (XTAL_P)
unnamed: R13.2, U3.C1 (MODE)
unnamed: L4.1, U3.B2 (SW)
unnamed: R10.2, U4.C1 (IREF)
unnamed: CHG0.-, U4.B2 (NCHG)
unnamed: R1.2, USB0.A5 (A5/CC1)
unnamed: R2.1, USB0.B5 (B5/CC2)
unnamed: C7.1, L5.2, X1.3 (X2)

Notes on the sheet:
SD Card
Layout note： Bottom
Camera
ICharge=24000/220K=110mA
MIC
Layout note： Same position as XIAO-C3
Imax=600mA
3.7~5V
0.3A/Pin
8MB Flash GD25Q64ENIGR


Parts:
U7: LOGO_CC_BY-SA_4.0

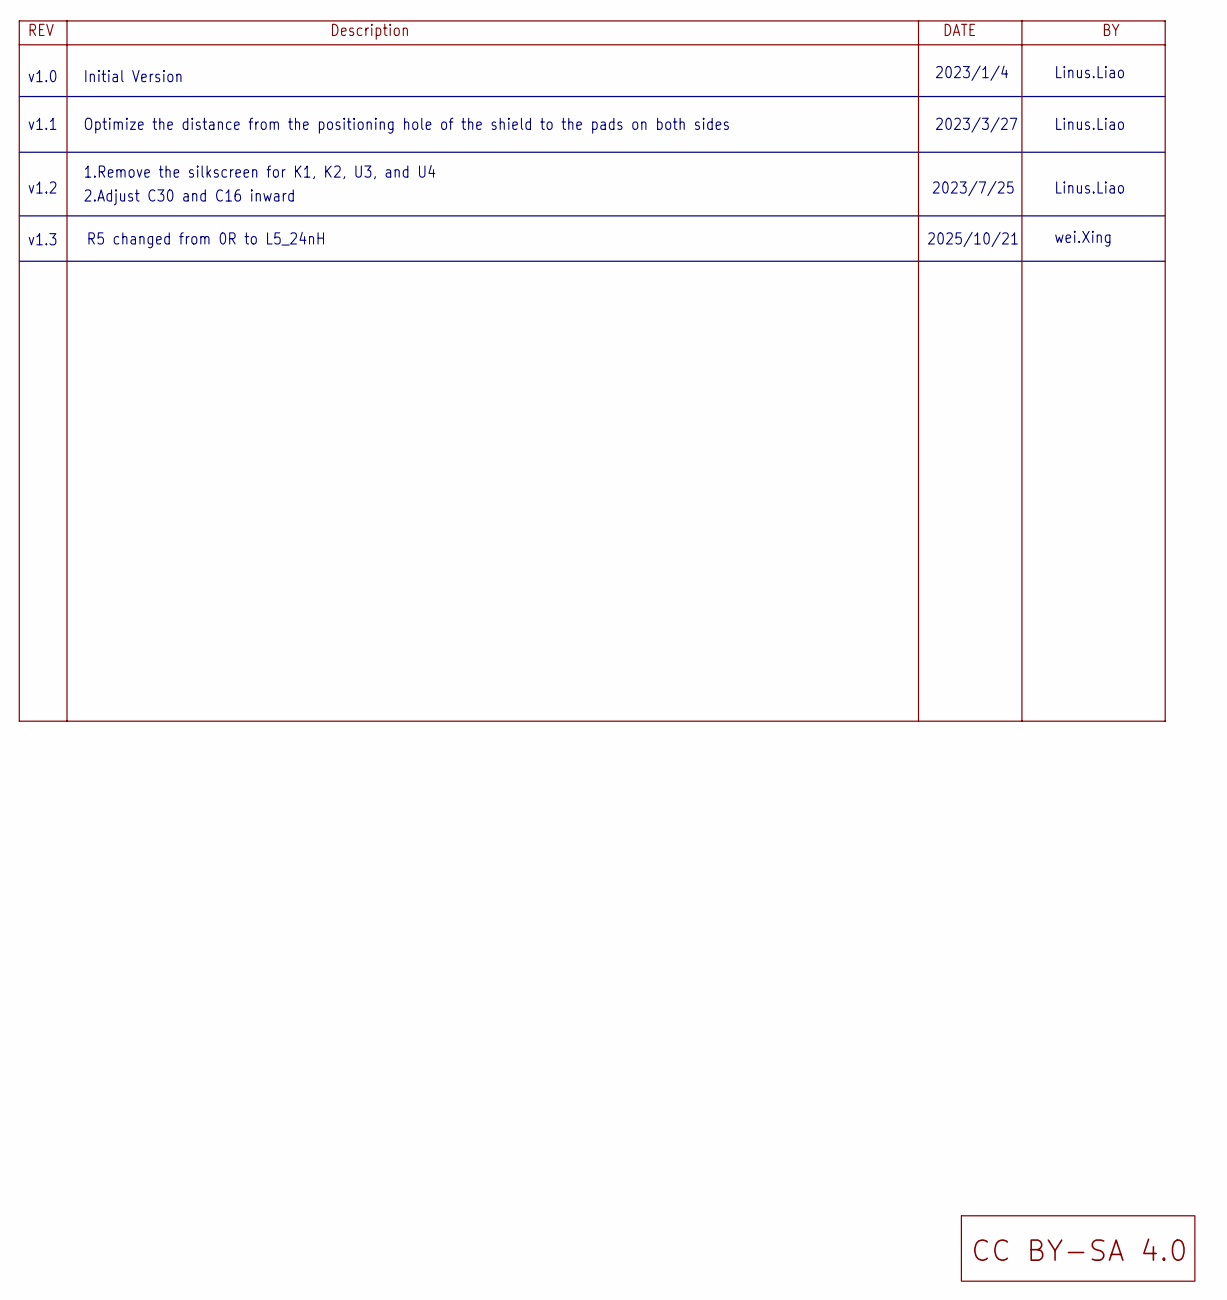
[picture p28: schematic 01 Descriptions.kicad_sch, XIAO ESP32-S3-Sense]

Parts:
U2: LOGO_CC_BY-SA_4.0

Notes on the sheet:
wei.Xing
Initial Version
R5 changed from 0R to L5_24nH
2.Adjust C30 and C16 inward
v1.1
v1.3
Linus.Liao
v1.0
2025/10/21
2023/7/25
v1.2
2023/1/4
1.Remove the silkscreen for K1, K2, U3, and U4
Optimize the distance from the positioning hole of the shield to the pads on both sides
2023/3/27

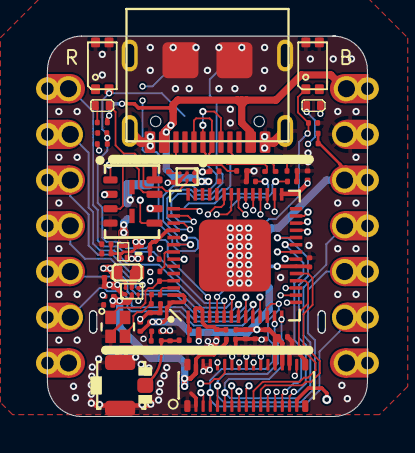
[picture p29: board XIAO ESP32S3_V1.5.kicad_pcb from above]

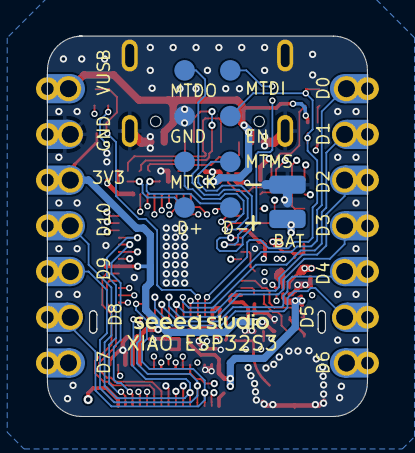
[picture p30: board XIAO ESP32S3_V1.5.kicad_pcb from below]

Board: 4 copper layers, 17.8 x 21.1 mm, 70 parts (10 on the bottom side), 62 nets.
