Juno31/imu-daq/hardware/dimension/xiao_esp32c3/KiCad_v1.3_extracted/202003511_XIAO ESP32C3_v1.3_SCH&PCB_260116/XIAO ESP32C3_v1.3.kicad_pcb

## KiCad design hardware/dimension/xiao_esp32c3/KiCad_v1.3_extracted/202003511_XIAO ESP32C3_v1.3_SCH&PCB_260116/XIAO ESP32C3_v1.3.kicad_pcb (2026-11-13)

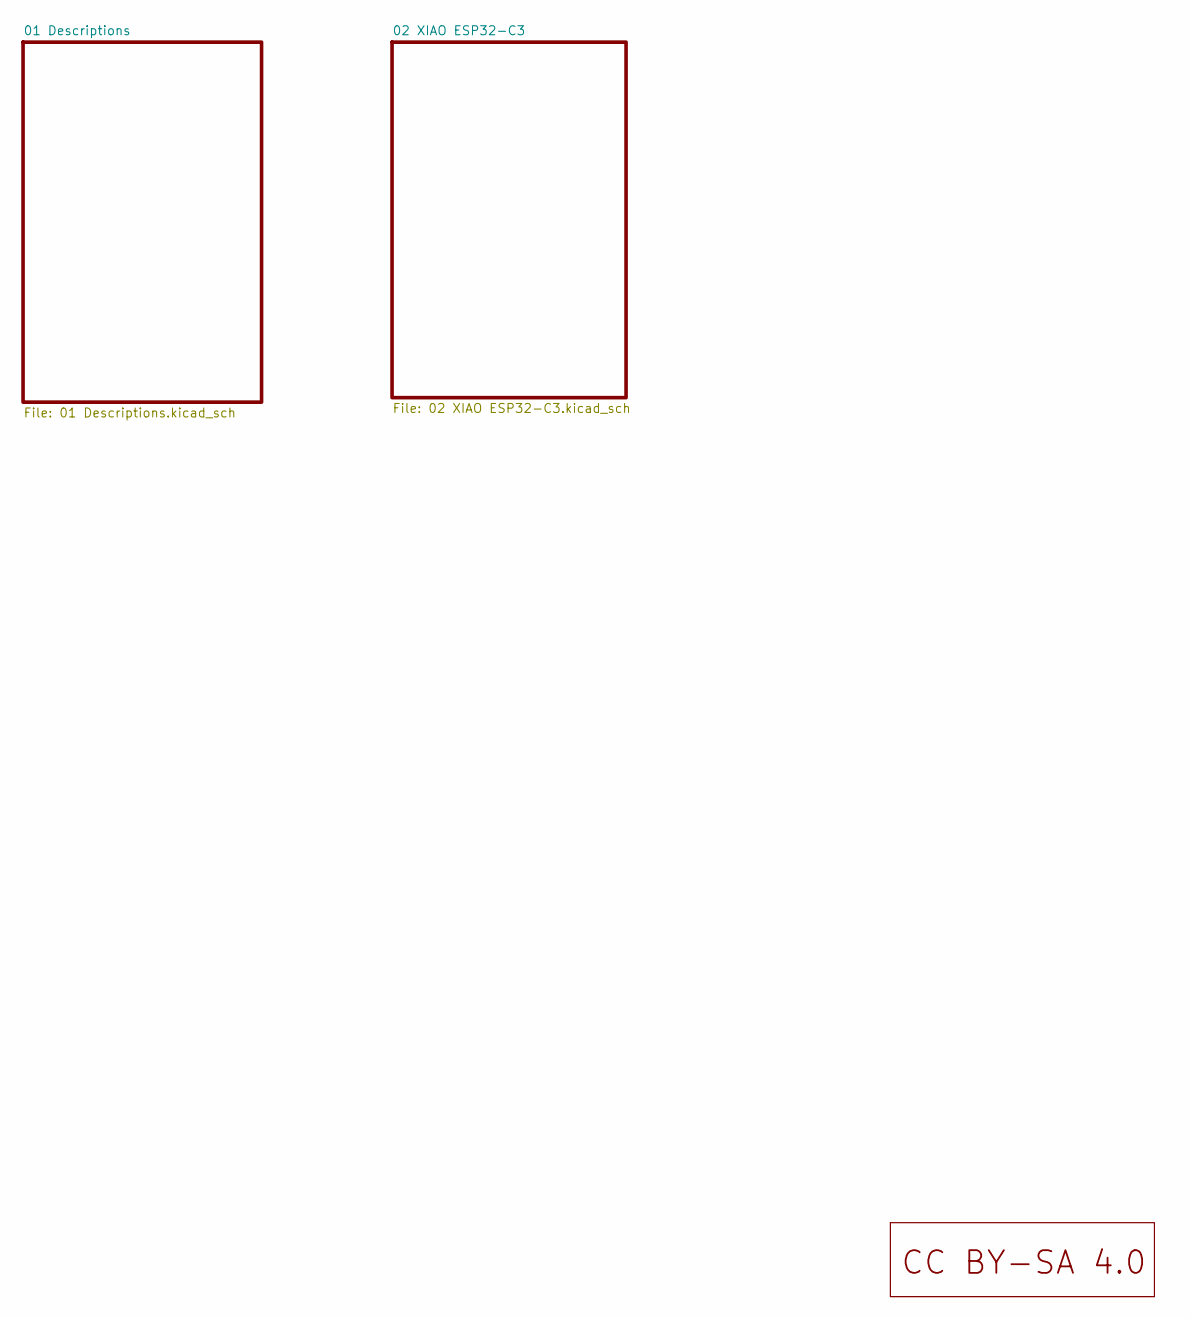
[picture p31: schematic XIAO ESP32C3_v1.3.kicad_sch, XIAO ESP32-C3]

Parts:
U3: LOGO_CC_BY-SA_4.0

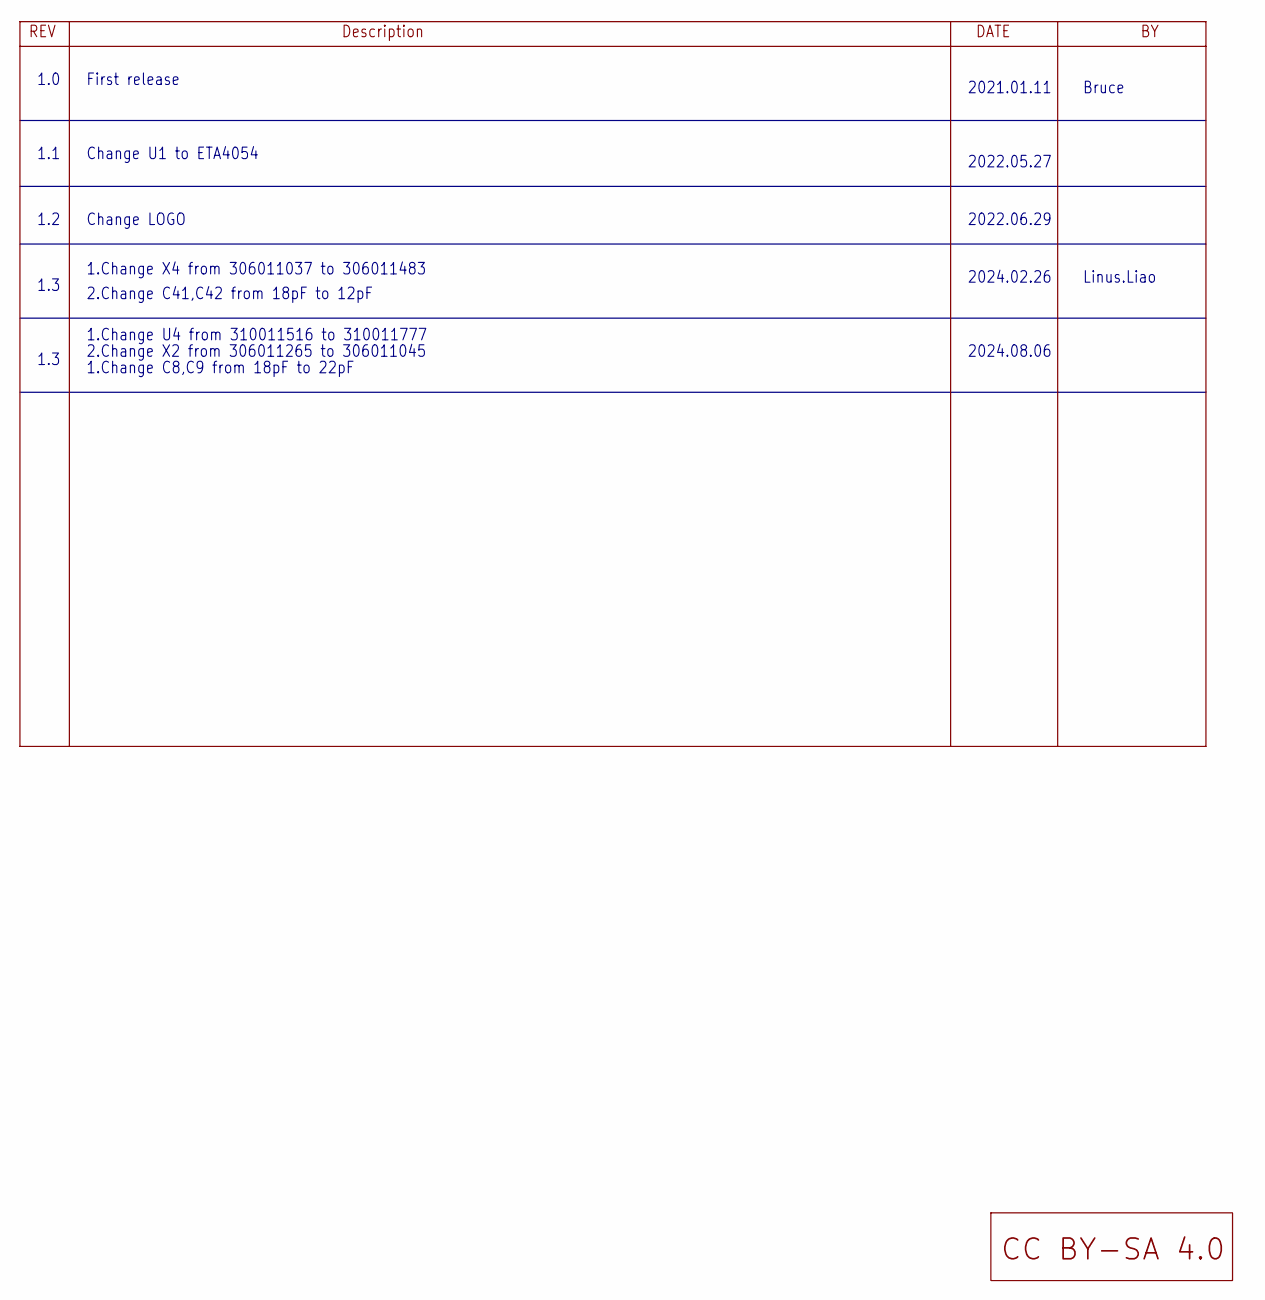
[picture p32: schematic 01 Descriptions.kicad_sch, XIAO ESP32-C3]

Parts:
U5: LOGO_CC_BY-SA_4.0

Notes on the sheet:
1.0
1.Change X4 from 306011037 to 306011483
1.Change U4 from 310011516 to 310011777
1.3
1.2
2.Change C41,C42 from 18pF to 12pF
2022.06.29
2022.05.27
Linus.Liao
2.Change X2 from 306011265 to 306011045
Bruce
2024.08.06
1.1
Change LOGO
2024.02.26
2021.01.11
First release
Change U1 to ETA4054
1.Change C8,C9 from 18pF to 22pF

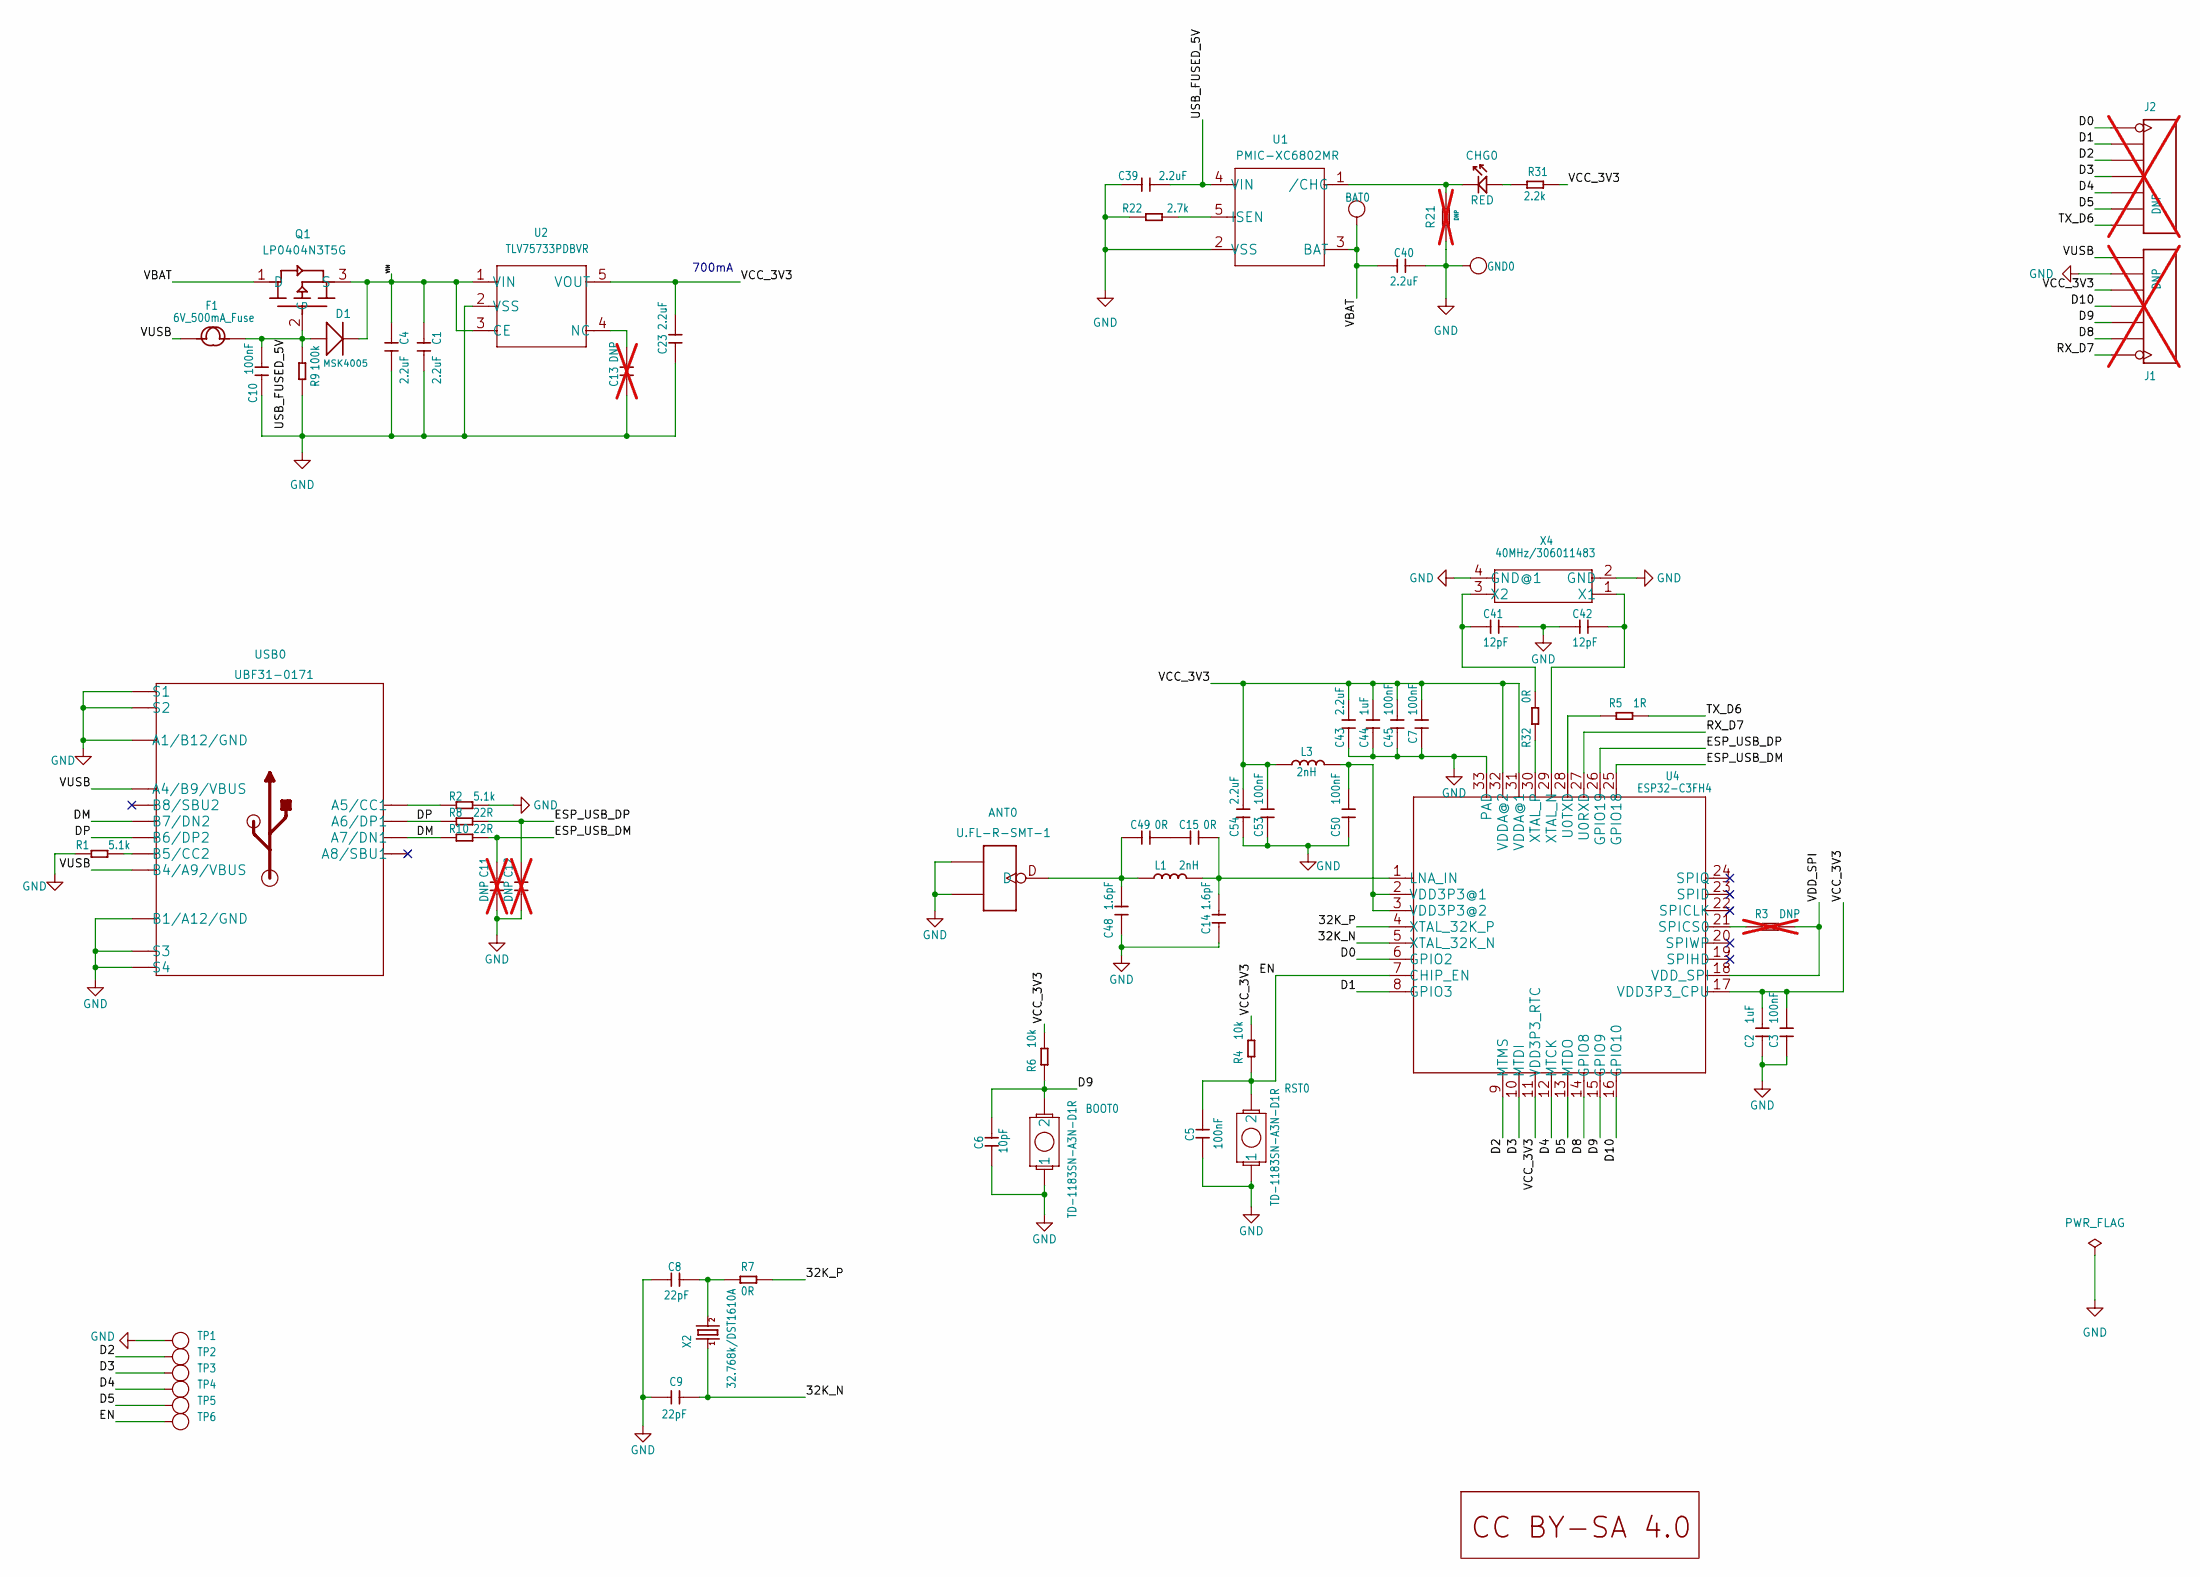
[picture p33: schematic 02 XIAO ESP32-C3.kicad_sch, XIAO ESP32-C3]

Parts:
ANT0: U.FL-R-SMT-1; U-FL3P-SMD-2.6X2.6X1.0MM
BAT0: DNP; TP-80X40MIL
BOOT0: TD-1183SN-A3N-D1R; BUTTON_TD1183SA
C1, C4, C23, C39, C40, C43, C54: 2.2uF; C0201
C2, C44: 1uF; C0201
C3, C5, C7, C10, C45, C50, C53: 100nF; C0201
C6: 10pF; C0201
C8, C9: 22pF; C0201
C11, C12, C13: DNP; C0201; not fitted
C14, C48: 1.6pF; C0201
C15, C49: 0R; C0201
C41, C42: 12pF; C0201
CHG0: RED; LED-0402
D1: MSK4005; SOD-523
F1: 6V_500mA_Fuse; F0603
GND0: DNP; TP-80X40MIL
J1, J2: DNP; H7-HALF-HOLE-2.54; not fitted
L1, L3: 2nH; L0201
Q1: LP0404N3T5G; PMOS_1.0_0.6_0.35MM
R1, R2: 5.1k; R0201
R3, R21: DNP; R0201; not fitted
R4, R6: 10k; R0201
R5: 1R; R0201
R7, R32: 0R; R0201
R8, R10: 22R; R0201
R9: 100k; R0201
R22: 2.7k; R0201
R31: 2.2k; R0201
RST0: TD-1183SN-A3N-D1R; BUTTON_TD1183SA
TP1, TP2, TP3, TP4, TP5, TP6: DNP; TP-D45MIL
U1: PMIC-XC6802MR; SOT-25
U2: TLV75733PDBVR; SOT-25
U4: ESP32-C3FH4; QFN32G-0.5-5X5MM
U6: LOGO_CC_BY-SA_4.0
USB0: UBF31-0171; USB2.0-TYPE-C
X2: 32.768k/DST1610A; X2-SMD-1.6X1.0X0.5MM
X4: 40MHz/306011483; X4-SMD-2.0X1.6X0.5MM

Connections:
32K_N: C9.1, U4.5 (XTAL_32K_N), X2.1
32K_P: R7.1, U4.4 (XTAL_32K_P)
D0: J2.1, J2.13 (1), U4.6 (GPIO2)
D1: J2.2, J2.14 (2), U4.8 (GPIO3)
D2: J2.3, J2.15 (3), TP2.T, U4.9 (MTMS)
D3: J2.4, J2.16 (4), TP3.T, U4.10 (MTDI)
D4: J2.5, J2.17 (5), TP4.T, U4.12 (MTCK)
D5: J2.6, J2.18 (6), TP5.T, U4.13 (MTDO)
D8: J1.2, J1.14 (2), U4.14 (GPIO8)
D9: BOOT0.2, C6.2, J1.3, J1.15 (3), R6.1, U4.15 (GPIO9)
D10: J1.4, J1.16 (4), U4.16 (GPIO10)
DM: R10.1, USB0.A7 (A7/DN1), USB0.B7 (B7/DN2)
DP: R8.1, USB0.A6 (A6/DP1), USB0.B6 (B6/DP2)
EN: C5.2, R4.1, RST0.2, TP6.T, U4.7 (CHIP_EN)
ESP_USB_DM: C11.2, R10.2, U4.25 (GPIO18)
ESP_USB_DP: C12.2, R8.2, U4.26 (GPIO19)
GND: ANT0.GND1, ANT0.GND2, BOOT0.1, C1.2, C2.1, C3.1, C4.2, C5.1, C6.1, C7.1, C8.2, C9.2, C10.1, C11.1, C12.1, C13.1, C14.1, C23.1, C39.1, C40.2, C41.2, C42.2, C43.1, C44.1, C45.1, C48.1, C50.1, C53.1, C54.1, GND0.1, J1.6, J1.18 (6), R1.1, R2.2, R9.1, R21.2, R22.2, RST0.1, TP1.T, U1.2 (VSS), U2.2 (VSS), U4.33 (PAD), USB0.A1_B12 (A1/B12/GND), USB0.B1_A12 (B1/A12/GND), USB0.S1, USB0.S2, USB0.S3, USB0.S4, USB0.S5 (S1), USB0.S6 (S2), X4.2 (GND), X4.4 (GND@1)
unnamed: R2.1, USB0.A5 (A5/CC1)
unnamed: R1.2, USB0.B5 (B5/CC2)
unnamed: R3.1, U4.21 (SPICS0)
unnamed: C8.1, R7.2, X2.2
unnamed: C13.2, U2.4 (NC)
unnamed: C15.2, C49.1
unnamed: R22.1, U1.5 (ISEN)
unnamed: CHG0.+, R31.2
unnamed: C14.2, C15.1, L1.2, U4.1 (LNA_IN)
unnamed: C41.1, R32.2, X4.3 (X2)
unnamed: C42.1, U4.29 (XTAL_N), X4.1 (X1)
unnamed: ANT0.D, C48.2, C49.2, L1.1
unnamed: R5.2, U4.28 (U0TXD)
unnamed: C50.2, L3.2, U4.2 (VDD3P3@1), U4.3 (VDD3P3@2)
unnamed: R32.1, U4.30 (XTAL_P)
RX_D7: J1.1, J1.13 (1), U4.27 (U0RXD)
TX_D6: J2.7, J2.19 (7), R5.1
USB_FUSED_5V: C10.2, C39.2, D1.+, F1.2, Q1.2 (G), R9.2, U1.4 (VIN)
VBAT: BAT0.1, C40.1, Q1.1 (D), U1.3 (BAT)
VCC_3V3: C2.2, C3.2, C7.2, C23.2, C43.2, C44.2, C45.2, C53.2, C54.2, J1.5, J1.17 (5), L3.1, R4.2, R6.2, R31.1, U2.5 (VOUT), U4.11 (VDD3P3_RTC), U4.17 (VDD3P3_CPU), U4.31 (VDDA@1), U4.32 (VDDA@2)
VDD_SPI: R3.2, U4.18 (VDD_SPI)
VIN: C1.1, C4.1, D1.-, Q1.3 (S), U2.1 (VIN), U2.3 (CE)
VUSB: F1.1, J1.7, J1.19 (7), USB0.A4_B9 (A4/B9/VBUS), USB0.B4_A9 (B4/A9/VBUS)
~CHG: CHG0.-, R21.1, U1.1 (/CHG)

Notes on the sheet:
700mA

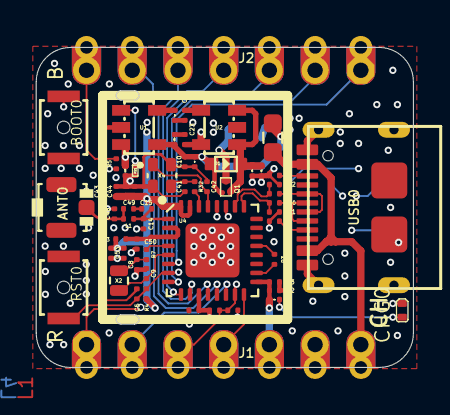
[picture p34: board XIAO ESP32C3_v1.3.kicad_pcb from above]

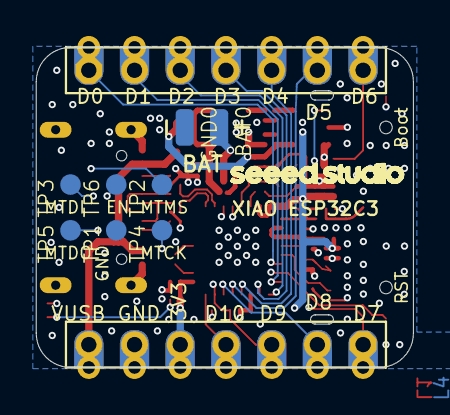
[picture p35: board XIAO ESP32C3_v1.3.kicad_pcb from below]

Board: 4 copper layers, 21.0 x 17.8 mm, 68 parts (9 on the bottom side), 41 nets.

Other parts of the board:
U$2: LOGO-SEEED-NEW-1X9.6MM
