Juno31/imu-daq/hardware/dimension/sparkfun_bno086/Eagle_v10_extracted/SparkFun_VR_IMU_Breakout_BNO086_QWIIC.brd

## EAGLE design hardware/dimension/sparkfun_bno086/Eagle_v10_extracted/SparkFun_VR_IMU_Breakout_BNO086_QWIIC.brd (2026-11-13)

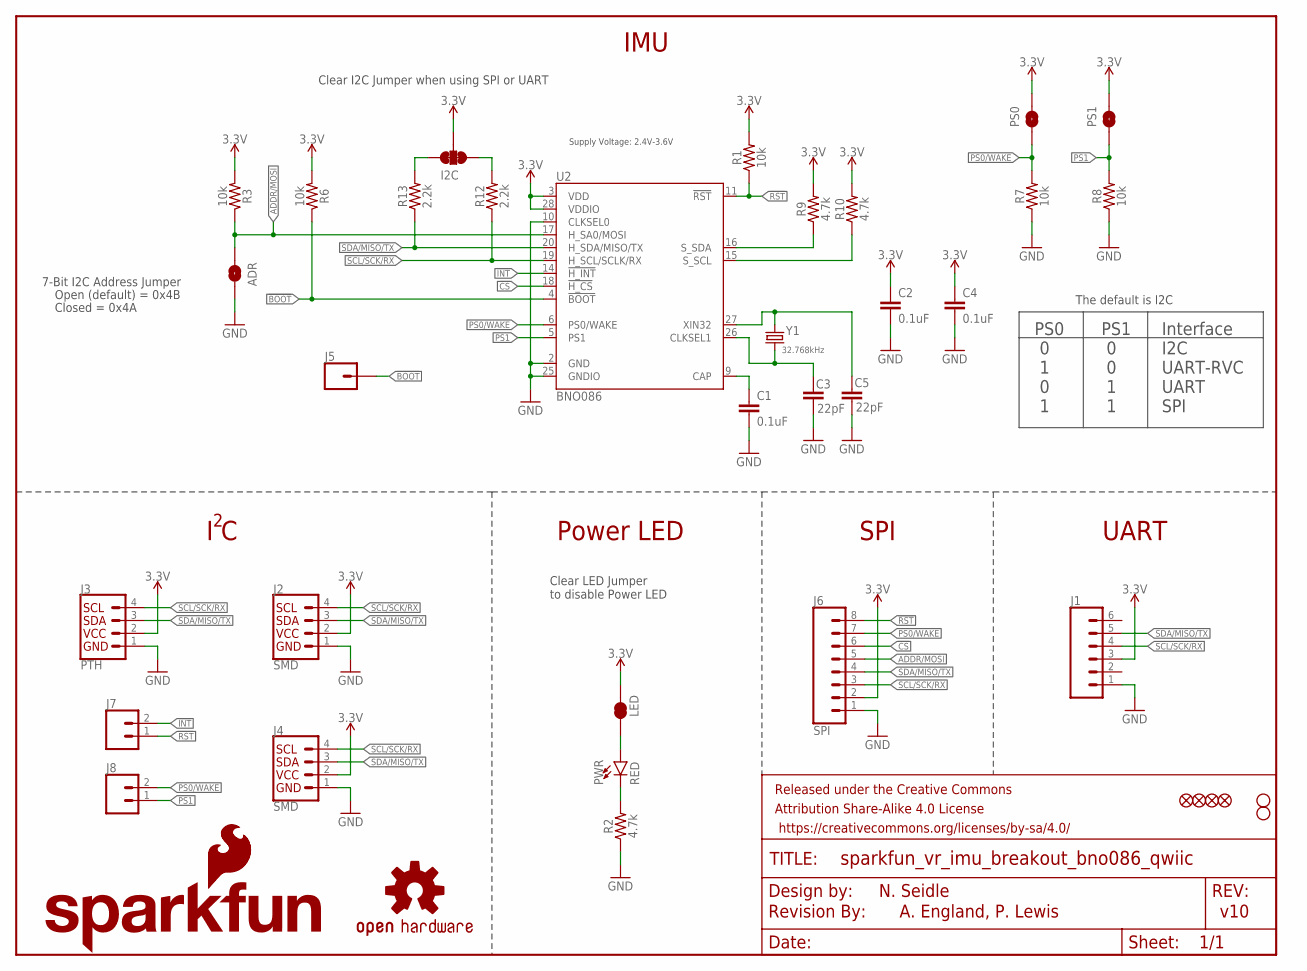
[picture p36: schematic SparkFun_VR_IMU_Breakout_BNO086_QWIIC.sch]

Parts:
ADR: JUMPER-SMT_2_NO_SILK; SMT-JUMPER_2_NO_SILK
C1, C2, C4: 0.1uF; 0603
C3, C5: 22pF; 0603
FRAME1: FRAME-LETTER; CREATIVE_COMMONS
I2C: JUMPER-SMT_3_2-NC_TRACE_SILK; SMT-JUMPER_3_2-NC_TRACE_SILK
J1: CONN_06NO_SILK_FEMALE_PTH; 1X06_NO_SILK
J2, J4: SMD; JST04_1MM_RA
J3: PTH; 1X04_NO_SILK
J5: CONN_01PTH_NO_SILK_YES_STOP; 1X01_NO_SILK
J6: SPI; 1X08_NO_SILK
J7, J8: CONN_021X02_NO_SILK; 1X02_NO_SILK
JP1, JP2, JP5, JP6: FIDUCIALUFIDUCIAL; FIDUCIAL-MICRO
JP3, JP4: STAND-OFF
LED: JUMPER-SMT_2_NC_TRACE_SILK; SMT-JUMPER_2_NC_TRACE_SILK
LOGO1: OSHW-LOGOMINI; OSHW-LOGO-MINI
LOGO2: REVISION
LOGO4: SFE_LOGO_FLAME.2_INCH; SFE_LOGO_FLAME_.2
LOGO5: SFE_LOGO_NAME_FLAME.1_INCH; SFE_LOGO_NAME_FLAME_.1
PS0, PS1: JUMPER-SMT_2_NO_SILK; SMT-JUMPER_2_NO_SILK
PWR: RED; LED-0603
R1, R3, R6, R7, R8: 10k; 0603
R2, R9, R10: 4.7k; 0603
R12, R13: 2.2k; 0603
U2: BNO086; LGA-28
Y1: 32.768kHz; CRYSTAL-SMD-3.2X1.5MM

Connections:
3.3V: C2.1, C4.1, I2C.2, J1.3, J2.2, J3.2, J4.2, J6.2, LED.1, PS0.1, PS1.1, R1.2, R3.2, R6.2, R9.2, R10.2, U2.3 (VDD), U2.28 (VDDIO)
!BOOT: J5.1, R6.1, U2.4 (!BOOT)
!CS: J6.6, U2.18 (!H_CS)
!INT: J7.2, U2.14 (!H_INT)
!RST: J6.8, J7.1, R1.1, U2.11 (!RST)
ADDR/MOSI: ADR.2, J6.5, R3.1, U2.17 (H_SA0/MOSI)
CAP: C1.1, U2.9 (CAP)
GND: ADR.1, C1.2, C2.2, C3.2, C4.2, C5.2, J1.1, J2.1, J3.1, J4.1, J6.1, R2.1, R7.1, R8.1, U2.2 (GND), U2.10 (CLKSEL0), U2.25 (GNDIO)
unnamed: C5.1, U2.27 (XIN32), Y1.P$2 (2)
unnamed: C3.1, U2.26 (CLKSEL1), Y1.P$1 (1)
unnamed: PWR.C, R2.2
unnamed: LED.2, PWR.A
PS0/WAKE: J6.7, J8.2, PS0.2, R7.2, U2.6 (PS0/WAKE)
PS1: J8.1, PS1.2, R8.2, U2.5 (PS1)
SCL/SCK/RX: J1.4, J2.4, J3.4, J4.4, J6.3, R12.1, U2.19 (H_SCL/SCLK/RX)
SCL_PU: I2C.1, R12.2
SDA/MISO/TX: J1.5, J2.3, J3.3, J4.3, J6.4, R13.1, U2.20 (H_SDA/MISO/TX)
SDA_PU: I2C.3, R13.2
S_SCL: R10.1, U2.15 (S_SCL)
S_SDA: R9.1, U2.16 (S_SDA)

Notes on the sheet:
N. Seidle
v10
7-Bit I2C Address Jumper
Closed = 0x4A
Open (default) = 0x4B
PS0 0 1 0 1
PS1 0 0 1 1
Interface I2C UART-RVC UART SPI
The default is I2C
Clear I2C Jumper when using SPI or UART
I C
UART
SPI
A. England, P. Lewis
Supply Voltage: 2.4V-3.6V
IMU
Clear LED Jumper to disable Power LED
Power LED

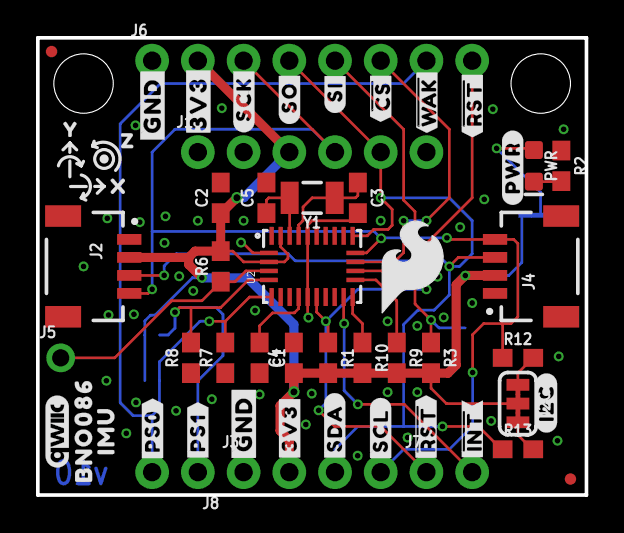
[picture p37: board SparkFun_VR_IMU_Breakout_BNO086_QWIIC.brd from above]

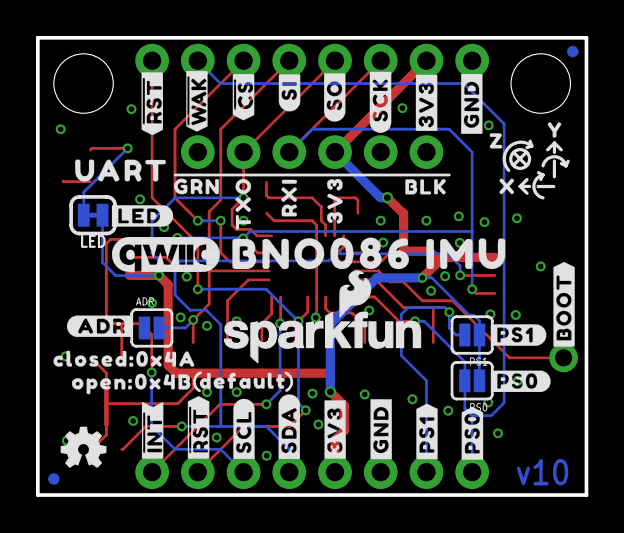
[picture p38: board SparkFun_VR_IMU_Breakout_BNO086_QWIIC.brd from below]

Board: 2 copper layers, 30.5 x 25.4 mm, 102 parts (43 on the bottom side), 20 nets.

Other parts of the board:
U$1: #I2C#874
U$2: BLK889
U$3, U$25: X878
U$4: ##INT##6
U$5: ##RST##5
U$6, U$10: Y879
U$7, U$15: Z880
U$8: #SCL#4
U$9, U$16: #GND#2
U$11: #SCK#882
U$12: #SO#867
U$13: #SI#868
U$14: #SDA#3
U$17: ##CS##870
U$18: ##CS##885
U$19: ##RST##872
U$20: ##RST##887
U$21: RXI891
U$22: TXO892
U$23: #PS0#874
U$24: BNO0861
U$26: #LED#0
U$27, U$46: #3V3#874
U$28: OPEN#0X4B0
U$29: QWIIC_4MM
U$30: #ADR#894
U$31: IMU862
U$32, U$45: #GND#864
U$33: #PS1#1
U$34: #PS0#2
U$35: #PS1#895
U$36: #3V3#865
U$37: #SCK#866
U$38: ##WAK##871
U$39: #3V3#882
U$40: 3V3891
U$41: GRN890
U$42: #PWR#873
U$43: #PS1#874
U$44: UART881
U$47: #SDA#874
U$48: #SCL#875
U$49: #BOOT#888
U$50: ##RST##876
U$51: ##INT##877
U$52: QWIIC_6MM
U$53: ##WAK##886
U$54: BNO086_IMU881
U$55: #SO#883
U$56: #SI#884
U$57: #PS0#895
U$58: CLOSED#0X4A0
U$59: ORDERING_INSTRUCTIONS
U$61: DEFAULT0
