Juno31/imu-daq/hardware/dimension/adafruit_bno085/Adafruit_BNO08x.brd

## EAGLE design hardware/dimension/adafruit_bno085/Adafruit_BNO08x.brd (2026-11-13)


Parts:
C1, C4, C5: 0.1uF; 0603-NO
C2, C3: 10uF; 0805-NO
C6, C7: 22pF; 0603-NO
CONN3, CONN4: STEMMA_I2C_QT; JST_SH4
D1: GREEN; CHIPLED_0603_NOOUTLINE
FID3, FID4: FIDUCIAL_1MM
JP1, JP2: HEADER-1X670MIL; 1X06_ROUND_70
Q2: BSS138; SOT363
R2, R3, R4: 10K; RESPACK_4X0603
SJ1: PS1; SOLDERJUMPER_ARROW_NOPASTE
SJ2: PS0; SOLDERJUMPER_ARROW_NOPASTE
U1: BNO080
U2: AP2112K-3.3; SOT23-5
U3: 74AHC4050; TSSOP16
U$1, U$17, U$19, U$21: MOUNTINGHOLE2.5; MOUNTINGHOLE_2.5_PLATED
X1: 32.768; XTAL3215

Connections:
3.3V: C1.1, C3.1, C5.1, JP1.2, Q2.2 (G), Q2.5 (G), R2.5 (2), R3.3 (1), R3.5 (2), U1.3 (VDD), U1.28 (VDDIO), U2.5 (OUT), U3.1 (VCC)
BOOT: JP2.1, R2.3 (1), U3.7 (3A)
BOOT_3V: U1.4 (BOOTN), U3.6 (3Y)
CAP: C4.2, U1.9 (CAP)
CS: JP2.6, R4.1, U3.9 (4A)
CS_3V: U1.18 (H_CSN), U3.10 (4Y)
GND: C1.2, C2.2, C3.2, C4.1, C5.2, C6.2, C7.2, CONN3.1 (GND), CONN3.MT1 (MT), CONN3.MT2 (MT), CONN4.1 (GND), CONN4.MT1 (MT), CONN4.MT2 (MT), D1.C, JP1.3, R2.7 (2), R2.8 (2), R3.1, R3.2 (1), R3.8 (2), U1.2 (GND), U1.10 (CLKSEL0), U1.25 (GNDIO), U2.2 (GND), U3.8 (GND)
INT: JP1.6, U1.14 (H_INTN)
MOSI: JP2.5, R3.7 (2), U3.11 (5A)
MOSI_3V: U1.17 (H_SA0/MOSI), U3.12 (5Y)
unnamed: D1.A, R2.4 (1)
PS0: JP2.2, R2.2 (1), SJ2.2, U3.3 (1A)
PS0_3V: U1.6 (PS0/WAKE), U3.2 (1Y)
PS1: JP2.3, R2.1, SJ1.2, U3.5 (2A)
PS1_3V: U1.5 (PS1), U3.4 (2Y)
RST: JP2.4, R4.2 (1), U3.14 (6A)
RST_3V: U1.11 (NRST), U3.15 (6Y)
SCL/SCK/RX: CONN3.4 (SCL), CONN4.4 (SCL), JP1.4, Q2.6 (D), R4.4 (1)
SCL_3V: Q2.1 (S), R3.4 (1), U1.19 (H_SCL/SCLK/RX)
SDA/MISO/TX: CONN3.3 (SDA), CONN4.3 (SDA), JP1.5, Q2.3 (D), R4.3 (1)
SDA_3V: Q2.4 (S), R3.6 (2), U1.20 (H_SDA/MISO/TX)
VCC: C2.1, CONN3.2 (V+), CONN4.2 (V+), JP1.1, R2.6 (2), R4.5 (2), R4.6 (2), R4.7 (2), R4.8 (2), SJ1.1, SJ2.1, U2.1 (IN), U2.3 (EN)
XIN: C6.1, U1.27 (XIN32), X1.P$1
XOUT: C7.1, U1.26 (CLKSEL1/XOUT32), X1.P$2

Notes on the sheet:
I2C Pullups & Shift
STEMMA/I2C Headers
ON LED
Power supply
Default Bus = I2C
Close PS1 for UART Close PS1 and PS0 for SPI
SA0 is default low, so I2C ADDR = 1001010 (0x4A)



Board: 2 copper layers, 25.4 x 22.9 mm, 32 parts (5 on the bottom side), 24 nets.

Other parts of the board:
U$22: ADAFRUIT_3.5MM
U$25: PCBFEAT-REV-040
U$30, U$31: STEMMAQT
