Juno31/imu-daq/(commit log)

2026-11-12 IMU DAQ: XIAO firmware, Python acquisition server and browser GUI
2026-11-12 GUI v1.2: status lights, EMG view, sync monitor, saved recordings, shortcuts
    - Compact GUI: DAQ/IMU/EMG/Sync status lights, one-line recording bar,
    collapsible IMU / EMG / Sync detail / Event log sections, settings drawer
    - Live EMG view (EMG01-08 on ai16-ai23, channels.py) with RMS and clipping
    - Idle DAQ preview so DAQ/EMG status works before Start
    - Saved recordings panel with per-file open; keyboard shortcuts (Space start/stop)
    - DAQ default 20 kHz; channel labels in daq_meta.json
    - Single server instance; clock fit reset after a board reboot
    - README rewritten for the current system
    [channels.py, daq.py, server.py]
2026-11-13 GUI v1.3: review, EMG normalization, organized flow, calibration jig
    - Main page: clearer step cards, calibration results table, participant
    height, spine model controls, spine view gated until calibrated
    - Review page: replay recordings (IMU, EMG, %MVC, spine model)
    - EMG normalization page: rest baseline, MVC/RVC captures, references
    - Hardware: IMU calibration jig
    [01 Descriptions.kicad_sch, 02 Block Diagram.kicad_sch, 02 XIAO ESP32-C3.kicad_sch, 03 XIAO ESP32-S3-Sense.kicad_sch, 4754_BNO085_STEMMA_QT.f3d, 4754_BNO085_STEMMA_QT.step, 4754_BNO085_STEMMA_QT.stl, Adafruit_BNO08x.brd]
2026-11-13 GUI: setup group + record block, shared live stream, spine cal fix
    - Main page: steps 1-3 grouped into a minimizable Setup block; Record
    trials is its own full-width block; each step minimizable with summary
    - One shared /api/stream per browser (SharedWorker) so many tabs no
    longer exhaust the 6-connection limit; direct fallback
    - Pages open in the same tab; leave-page warnings during captures
    - Spine calibration: server copy is master (load at start, GET, rev);
    stale pages can no longer clear the forward-bend axis
    - EMG norm: signals as main view, saved-recordings panel, editable trial
    numbers; Review shows EMG only for EMG norm captures; step 3c link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
    [server.py]
2026-11-13 README: setup / record flow, EMG norm, Review, shared stream, folder layout
